vchernokulsky/cashless-dev/_docs/PinMapping.pdf

Пин | Назначение
P13 | MDB-RES | Сброс модуля MDB
P12 | I2C3-SCL | Шина I2C для дисплея или внешних устройств
P11 | I2C3-SDA | Шина I2C для дисплея или внешних устройств
P10 | NFC-INT | Вход прерывания от NFC
P9 | DEBUG-RX | Отладочный UART
P8 | DEBUG-TX | Отладочный UART
P7 | GPIO-1 | Вывод общего назначения
P6 | GPIO-2 | Вывод общего назначения
P5 | GPIO-3 | Вывод общего назначения
P4 | GPIO-4 | Вывод общего назначения
P3 | GPIO-5 | Вывод общего назначения
P2 | LD-LINK | Светодиод состояния соединения «1» - светит (ON) «0» - не светит (OFF)
P1 | ETH-INT | Вход прерывания от Ethernet
P0 | ETH-RST | Сброс модуля Ethernet
А0 | MDB-RX
А1 | MDB-TX
А2 | WIFI-RX
А3 | WIFI-TX
А4 | WIFI-RES | Сброс модуля WIFI
А5 | LD-SERVICE | Светодиод состояния соединения «1» - светит (ON) «0» - не светит (OFF)
