vchernokulsky/cashless-dev/hardware/KiCad/Cables/Кабель MDB.odt

Перв. примен.
Справ. №

Подп. и дата
Инв. № дубл.
Взам. инв. №
Подп. и дата
Инв. № подл.

Перв. примен.
Справ. №

Подп. и дата
Инв. № дубл.
Взам. инв. №
Подп. и дата
Инв. № подл.

Зона | Поз. обозн. | Наименование | Кол. | Примечание
| | Разъемы, кнопки
| XP1 | Розетка на кабель 39-01-2060 ( 6 контактов, шаг 4.2 мм) | 1 | Примечание 1,2
| | Контакт | 3 | Примечание 1,3
| XP2 | Розетка на кабель CHU-3 | 1
| | Провода
| 1-3 | Кабель коммуникационный CCC-2G, L = 500 мм | 1
| | Примечания
| | Примечание 1
| | Производитель MOLEX
| | Примечание 2
| | Допускается замена на аналогичные изделия других производителей:
| | 172168-1 — производства TE Connectivity
| | DS1073-02-2x3-FСT6 — производства Ningbo Zhenqin Electronic (Connfly Electronic)
| | Примечание 3
| | Допускается замена на аналогичные изделия других производителей:
| | 171639-1 — производства TE Connectivity

Изм. Лист № документа Подпись Дата АБВГ.123456.000 ПЭ Лист 0

Изм. Лист № документа Подпись Дата АБВГ.123456.000 ПЭ Разраб. Касперович С.Ю. 22.04.16 Проверил Н.контр. Утвердил Кабель MDB перечень элементов Лит. Лист Листов 2 2 АО «»
