vchernokulsky/cashless-dev/hardware/KiCad/Cables/Кабель питания.odt

Перв. примен.
Справ. №

Подп. и дата
Инв. № дубл.
Взам. инв. №
Подп. и дата
Инв. № подл.

Перв. примен.
Справ. №

Подп. и дата
Инв. № дубл.
Взам. инв. №
Подп. и дата
Инв. № подл.

Зона | Поз. обозн. | Наименование | Кол. | Примечание
| | Разъемы
| XP1 | MOLEX 0019091151 | 1
| XP2 | MOLEX 0019092151 | 1
| XP3 | CHU-2 | 1
| | Прочее
| 1-4 | Провод НВ-4-0.2, L = 400 мм | 4

Изм. Лист № документа Подпись Дата АБВГ.123456.000 ПЭ Лист 0

Изм. Лист № документа Подпись Дата АБВГ.123456.000 ПЭ Разраб. Касперович С.Ю. 22.04.16 Проверил Н.контр. Утвердил Кабель питания перечень элементов Лит. Лист Листов 2 2 АО «»
