vchernokulsky/cashless-dev/hardware/KiCad/W5500Shield/W5500-SHiled.odt

Перв. примен.
Справ. №

Подп. и дата
Инв. № дубл.
Взам. инв. №
Подп. и дата
Инв. № подл.

Перв. примен.
Справ. №

Подп. и дата
Инв. № дубл.
Взам. инв. №
Подп. и дата
Инв. № подл.

Зона | Поз. обозн. | Наименование | Кол. | Примечание
| | Микросхемы
| DD1 | W5500 (LQFP-48) | 1 | Wiz Net
| | Диоды, транзисторы
| LD1 | SMD 0603 - KP-1608SGC | 1 | Kingbright
| | Резисторы
| R1 | SMD 0603 — 1M 1% (CRCW06031M00FKEA или RC0603FR-071ML) | 1 | VISHAY,Yageo
| R14 - R17 | SMD 0603 — 33 Ом 1% (RC0603FR-0733RL) | 4 | Yageo
| R20 - R23 | SMD 0603 — 49R9 1% (RC0603FR-0749R9L) | 4 | Yageo
| R18, R19, R25 | SMD 0603 — 330 Ом 5% (RC0603FR-07330RL) | 3 | Yageo
| R24 | SMD 0603 — 10R 1% (RC0603FR-0710RL) | 1 | VISHAY
| R3 | SMD 0603 — 0 Ом (RC0603JR-070RL) | 1 | Yageo
| R2, R4 — R12,R26, R27 | SMD 0603 — 10k 5% (RC0603FR-0710KL) | 12 | Yageo
| R13 | SMD 0603 — 12.4k 1% (RC0603FR-0712K4L) | 1 | Yageo
| | Конденсаторы
| C1, C3 | SMD 0603 - 18pF NP0 (GRM1885C1H180JA01D) | 2 | Murata
| C10 | SMD 0603 - 4.7uFx6V3 X7R (CC0603KRX5R5BB475) | 1 | Yageo
| C8, C11 | SMD 0603 – 10nF x 50V X7R (CC0603KRX7R9BB103) | 2 | Yageo
| C6, C7 | SMD 0603 – 6.8nF x 50V X7R (CC0603KRX7R9BB682) | 2 | Yageo
| C4, C9 | 10uFx16V Танталовый, тип А (293D106X9016A2TE3) | 2 | VISHAY
| C2, C5, C12, C15 - C21 | SMD 0603 - 100nFx10V X7R (CC0603KRX7R9BB104) | 10 | Yageo
| C14 | SMD 0603 - 22nFx50V X7R (CC0603KRX7R9BB223) | 1 | Yageo
| C13 | SMD 1206 – 1nFx2kV X7R (CC1206KKX7RDBB102) | 1 | Yageo
| | Индуктивности
| L1 | SMD 0603 — 1000 @ 100Mhz (BLM18AG102SN1D) | 1 | Murata
| | Кварцевые резонаторы
| X1 | ABM3C-25.000MHZ-D4Y-T | 1 | ABRACON
| | Разъемы
| XP1 | PLD-10 | 1
| P1 | HR911105A | 1
| | Прочее

Изм. Лист № документа Подпись Дата АБВГ.123456.000 ПЭ Лист 2

Изм. Лист № документа Подпись Дата АБВГ.123456.000 ПЭ Разраб. 22.04.16 Проверил Н.контр. Утвердил W5500-SHiled перечень элементов Лит. Лист Листов 1 2 АО «»
