vchernokulsky/cashless-dev/hardware/KiCad/W5500Shield/W5500 Shield-Низ.jpg

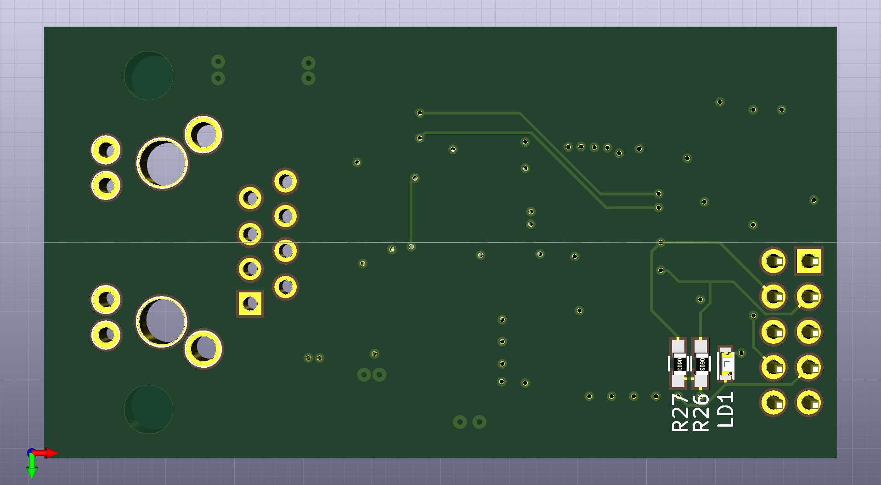
hardware/KiCad/W5500Shield/W5500 Shield-Низ.jpg
