vchernokulsky/cashless-dev/hardware/KiCad/KiCad.FCStd

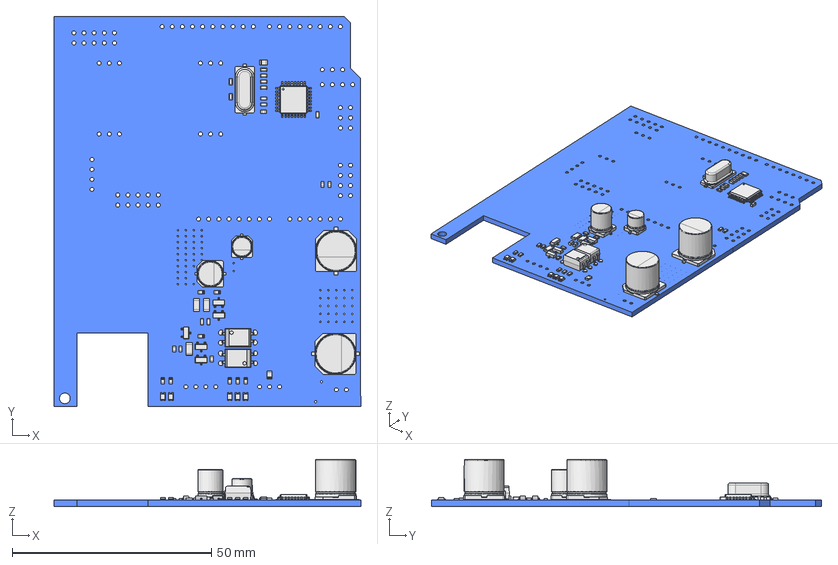
[picture p3: CAD file, 2016-11-25]
hardware/KiCad/KiCad.FCStd
76.9 x 97.8 x 11.8 mm
Pcb
c_0603_h078_
r_0603_h078_
r_0603_h078_001
r_0603_h078_002
r_0603_h078_003
r_0603_h078_004
r_0603_h078_005
r_0603_h078_006
r_0603_h078_007
DBCC3AE1-0DB8-4925-91AA-5759F3836E66_
User_Library-Crystal_HC49_US-SM_
r_0603_h078_008
c_0603_h078_001
r_0603_h078_009
r_0603_h078_010
r_1206_h055_
r_0603_h078_011
r_0603_h078_012
DBCC3AE1-0DB8-4925-91AA-5759F3836E66_001
DBCC3AE1-0DB8-4925-91AA-5759F3836E66_002
DBCC3AE1-0DB8-4925-91AA-5759F3836E66_003
DBCC3AE1-0DB8-4925-91AA-5759F3836E66_004
ASSEMBLY_
ASSEMBLY_001
ASSEMBLY_002
r_0805_h078_
ASSEMBLY_003
r_1206_h055_001
r_1206_h055_002
c_0603_h078_002
c_0603_h078_003
c_0603_h078_004
c_0603_h078_005
c_0603_h078_006
c_0603_h078_007
c_0603_h078_008
c_0603_h078_009
c_0603_h078_010
lqfp32_7x7_p08_
r_0805_h078_001
r_0603_h078_013
