vchernokulsky/cashless-dev/hardware/KiCad/W5500Shield/W5500 Shield-Edge.Cuts.dxf

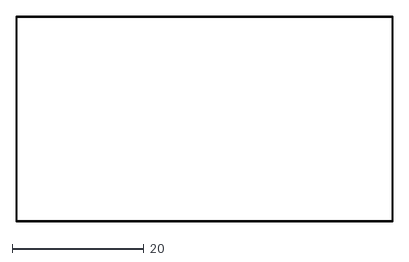
[picture p4: CAD file, 2016-11-25]
hardware/KiCad/W5500Shield/W5500 Shield-Edge.Cuts.dxf
57.1 x 31.1
