vchernokulsky/cashless-dev/hardware/KiCad/Ethernet-Shiled.dxf

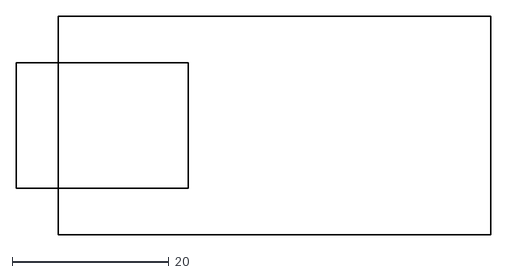
[picture p5: CAD file, 2016-11-25]
hardware/KiCad/Ethernet-Shiled.dxf
60.6 x 27.9
