vchernokulsky/cashless-dev/hardware/KiCad/W5500Shield/W5500 Shield-F.Fab.dxf

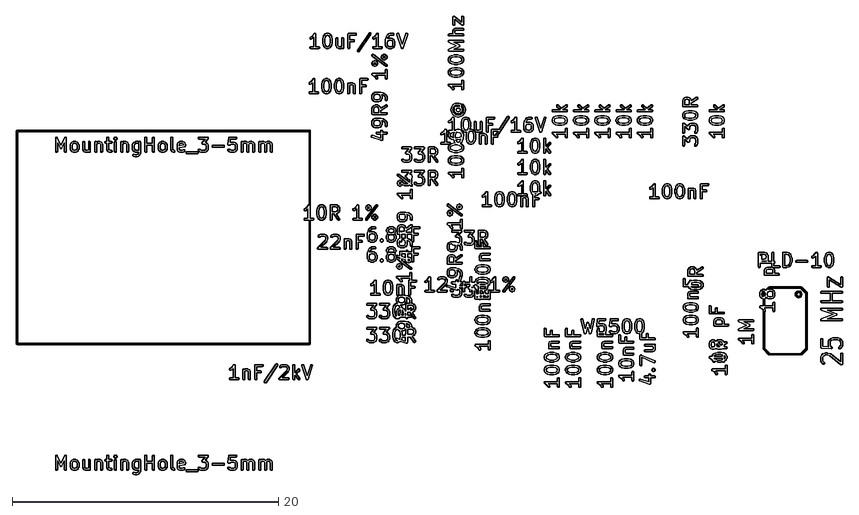
[picture p6: CAD file, 2016-11-25]
hardware/KiCad/W5500Shield/W5500 Shield-F.Fab.dxf
62.1 x 34.5
