vchernokulsky/cashless-dev/hardware/KiCad/CDRH127.dxf

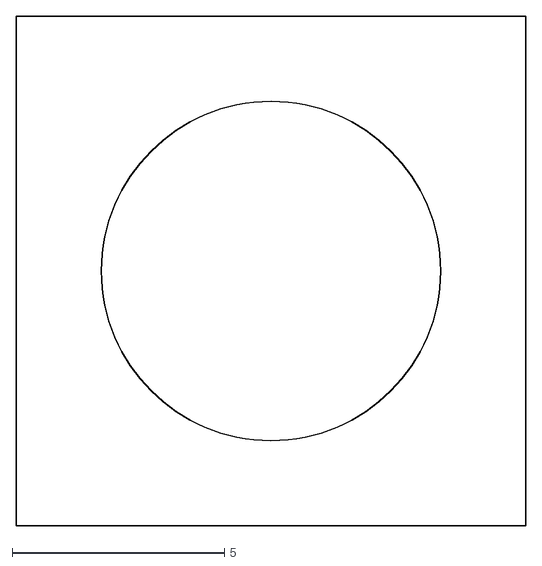
[picture p7: CAD file, 2016-11-25]
hardware/KiCad/CDRH127.dxf
12.0 x 12.0
