vchernokulsky/cashless-dev/hardware/KiCad/ABM3C.dxf

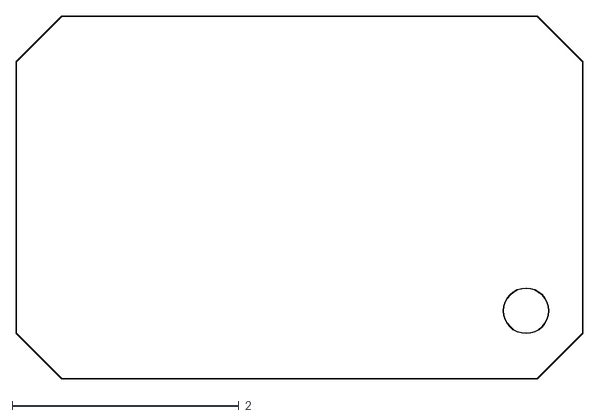
[picture p8: CAD file, 2016-11-25]
hardware/KiCad/ABM3C.dxf
5.00 x 3.20
