vchernokulsky/cashless-dev/hardware/KiCad/ESP8266-01.dxf

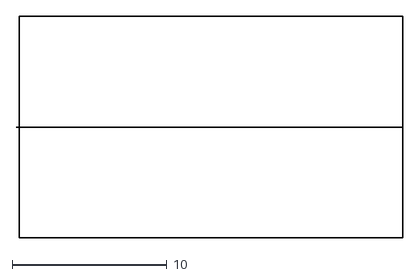
[picture p9: CAD file, 2016-11-25]
hardware/KiCad/ESP8266-01.dxf
25.0 x 14.3
