vchernokulsky/cashless-dev/hardware/KiCad/SL-ПЭ3.pdf

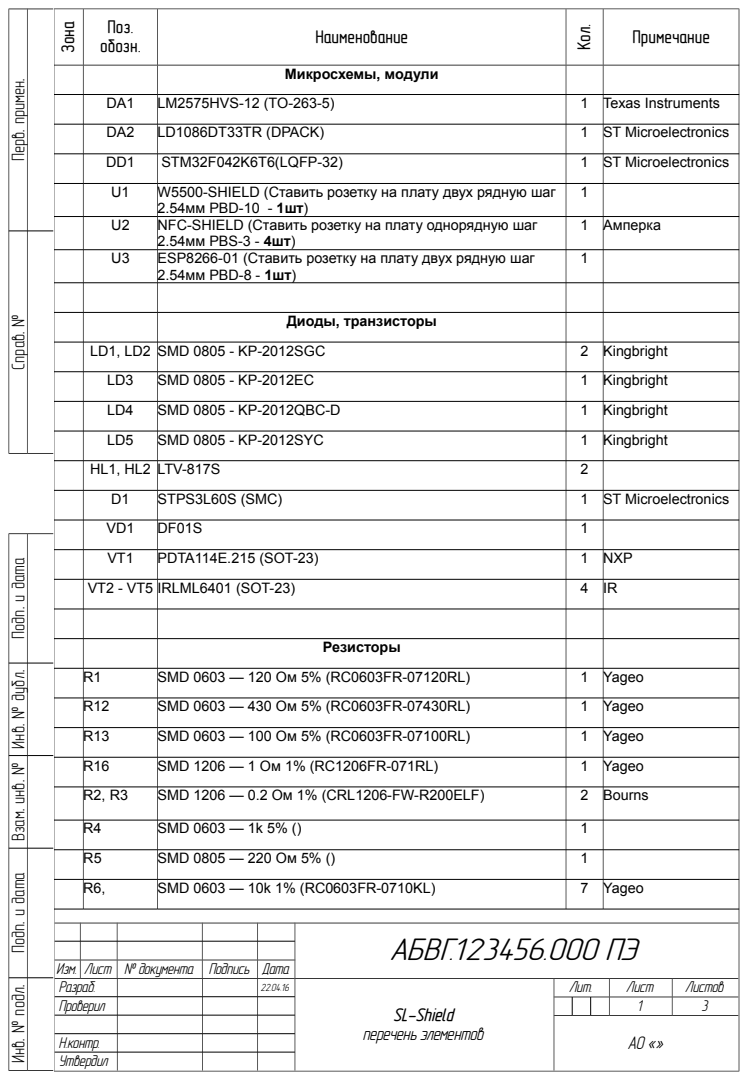
[picture p10: page 1]

Изм. Лист № документа Подпись Дата
Проверил

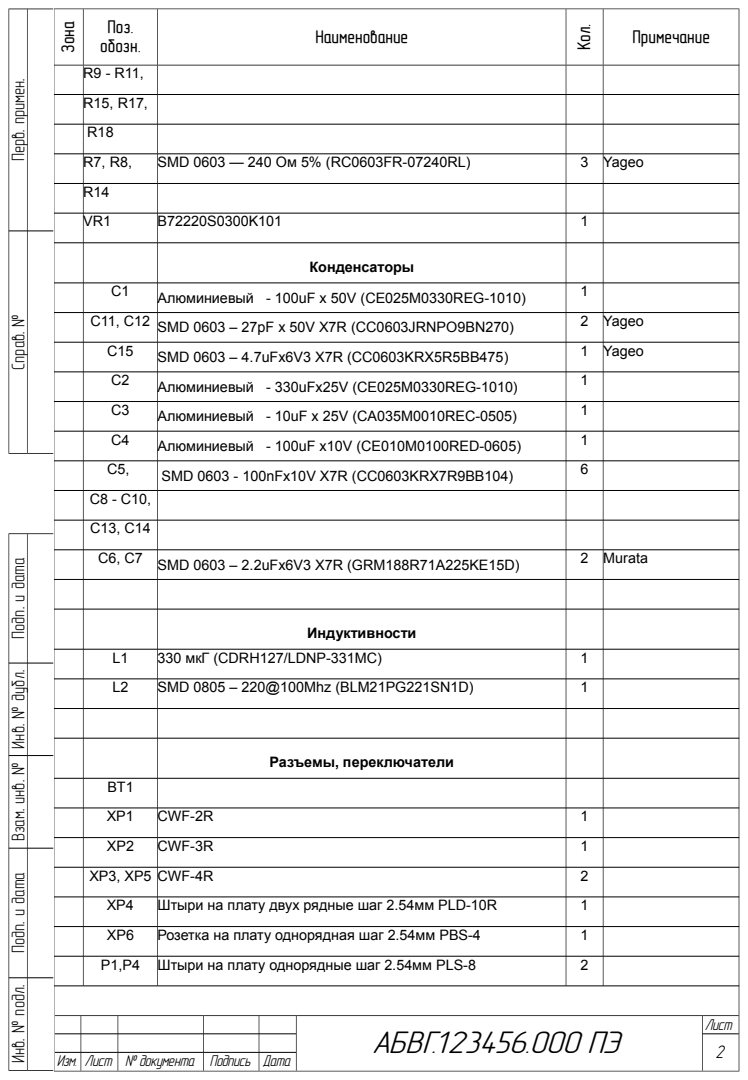
[picture p11: page 2]

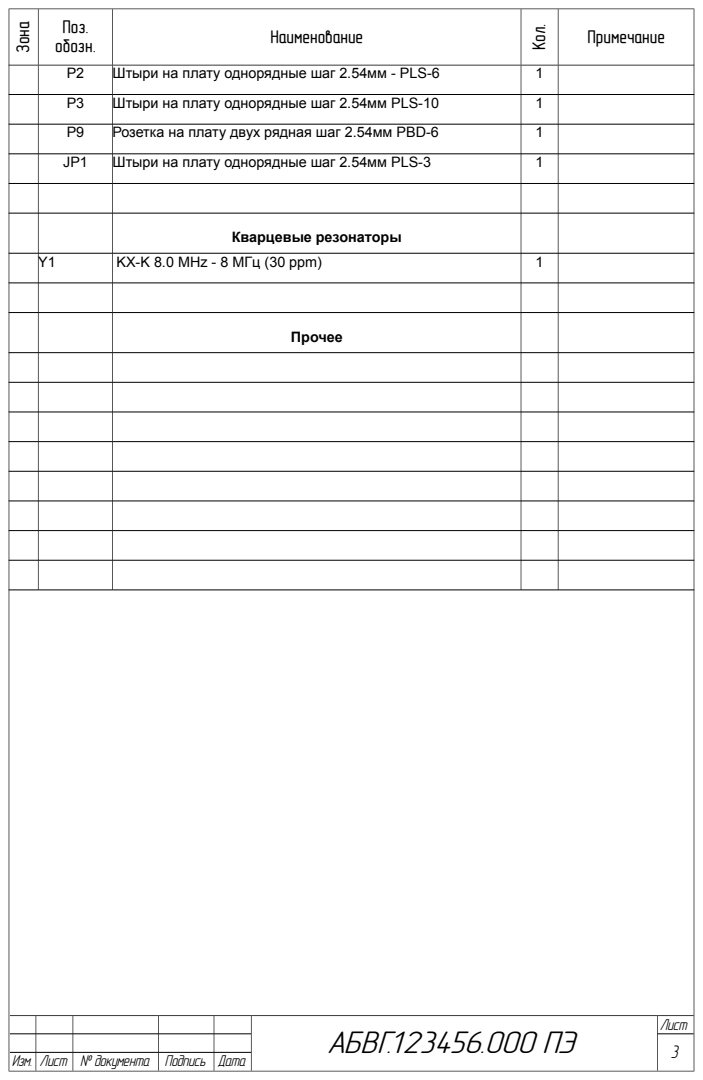
[picture p12: page 3]
Штыри на плату однорядные шаг 2.54мм - PLS-6; Штыри на плату однорядные шаг 2.54мм PLS-10; Розетка на плату двух рядная шаг 2.54мм PBD-6; Штыри на плату однорядные шаг 2.54мм PLS-3; Кварцевые резонаторы; KX-K 8.0 MHz - 8 МГц (30 ppm); Прочее; Изм.; Лист; № документа; Подпись; Дата; АБВГ.123456.000 ПЭ; Лист 3
