vchernokulsky/cashless-dev/hardware/KiCad/SL-СБ-ВЕРХ.pdf

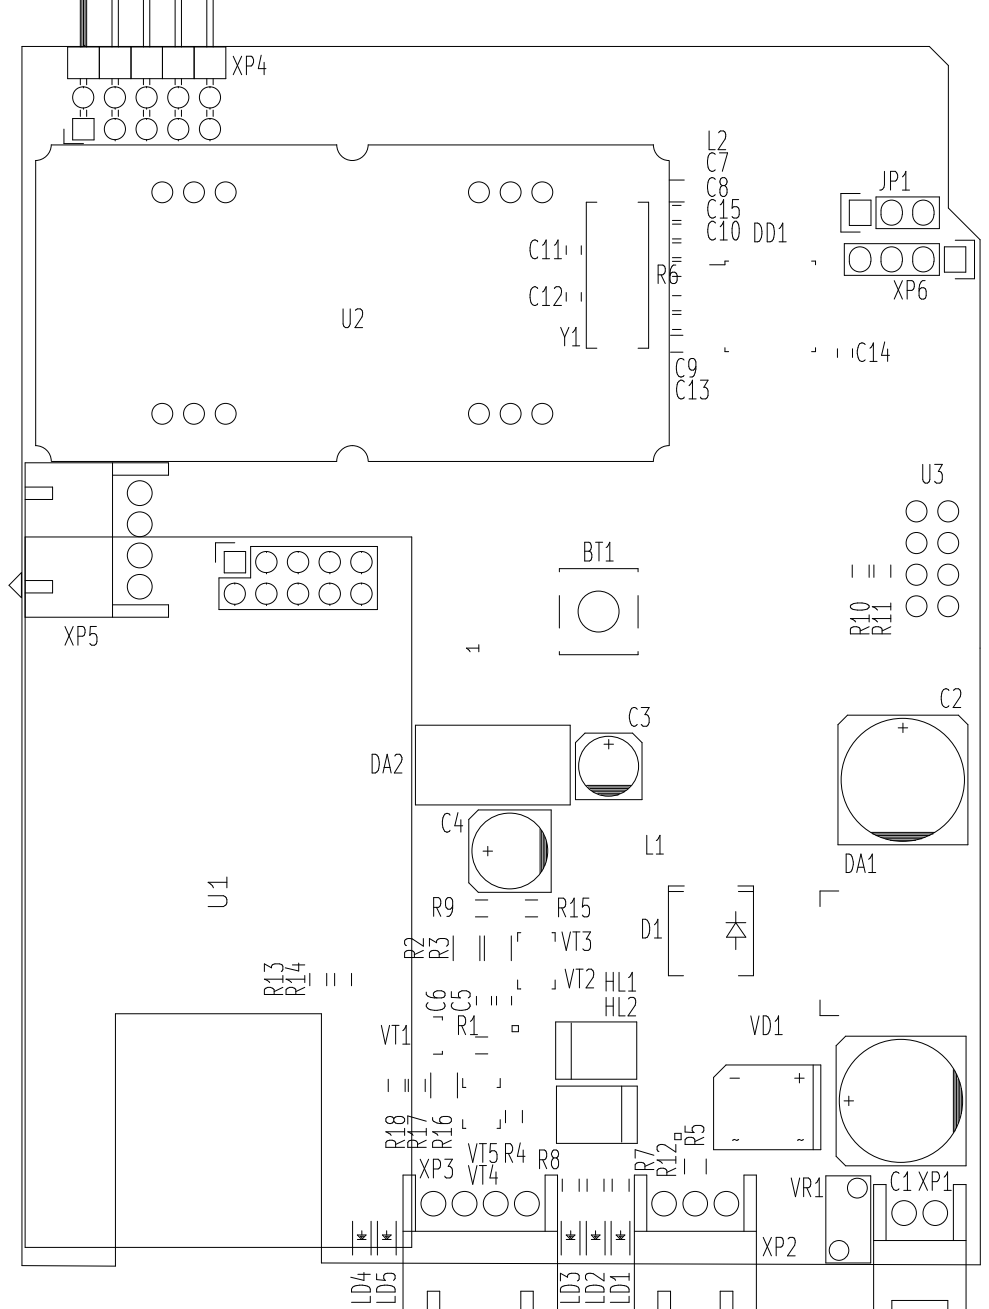
[picture p13: page 1]
