vchernokulsky/cashless-dev/hardware/KiCad/SL-СБ-НИЗ.pdf

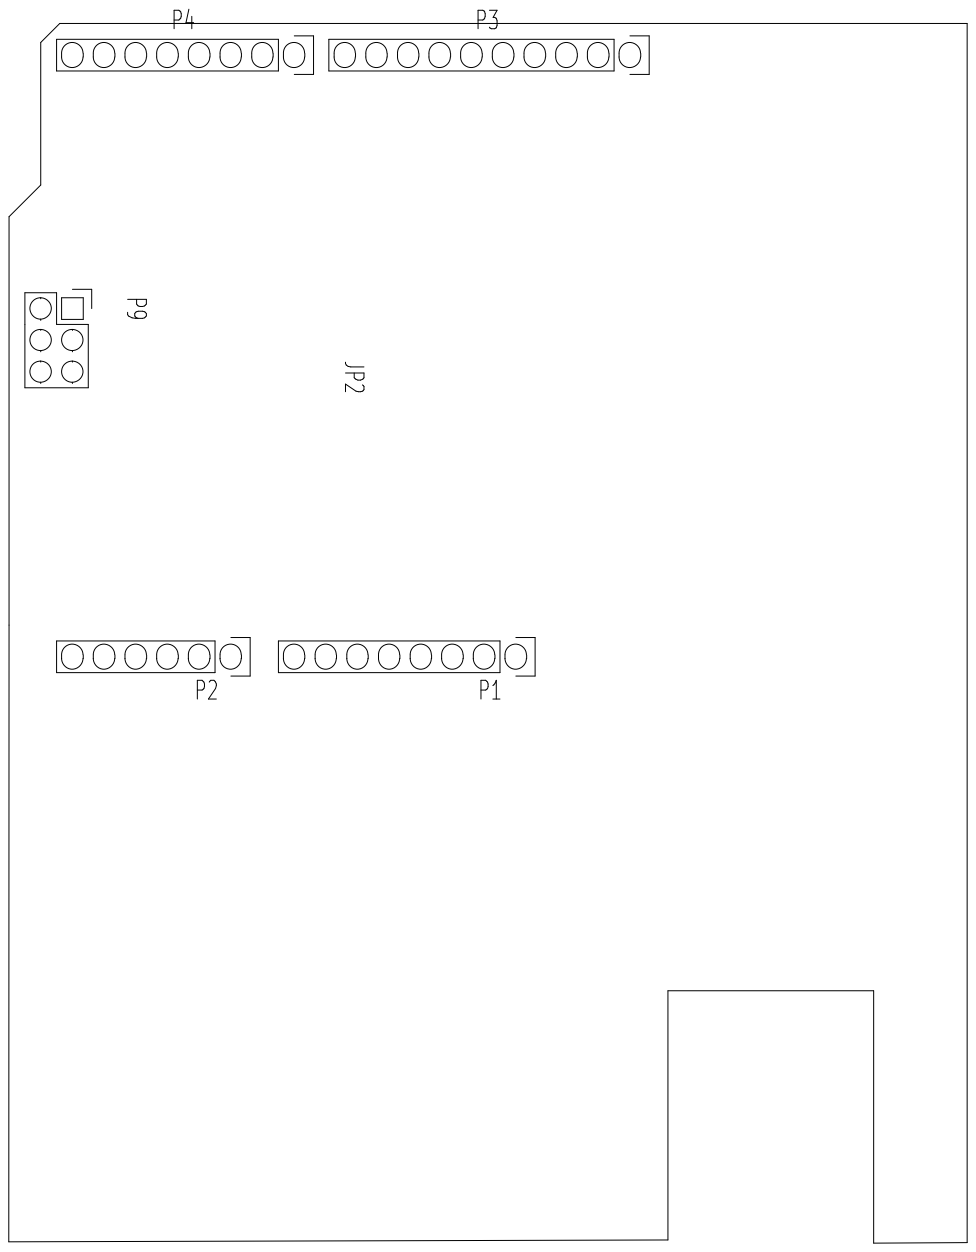
[picture p14: page 1]
