vchernokulsky/cashless-dev/hardware/KiCad/Cables/Кабель MDB - ПЭ3.pdf

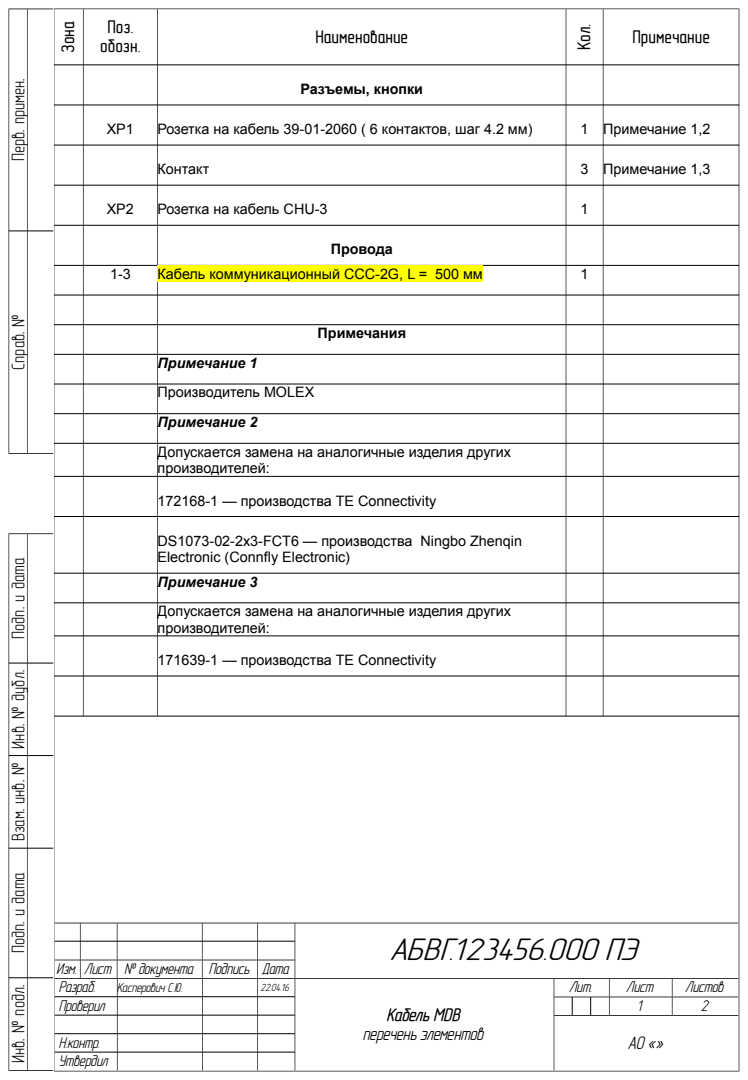
[picture p15: page 1]
Зона; Поз.; обозн.; Наименование; Кол.; Примечание; Разъемы, кнопки; Розетка на кабель 39-01-2060 ( 6 контактов, шаг 4.2 мм); 1 Примечание 1,2; Контакт; 3 Примечание 1,3; Розетка на кабель CHU-3; Провода; Кабель коммуникационный CCC-2G, L = 500 мм; Примечания; АБВГ.123456.000 ПЭ; Разраб.; Касперович С.Ю.; Н.контр. Утвердил; Кабель MDB перечень элементов; Лит.; Лист; Листов; Подп. и да; м. инв. №; Инв. № подл.

Перв. примен. Справ. №

Примечание 1
Производитель MOLEX
Примечание 2
Допускается замена на аналогичные изделия других
производителей:

172168-1 — производства TE Connectivity

DS1073-02-2x3-FСT6 — производства Ningbo Zhenqin
Electronic (Connfly Electronic)
Примечание 3

171639-1 — производства TE Connectivity

Инв. № дубл. Вза

Изм. Лист № документа Подпись Дата
Проверил

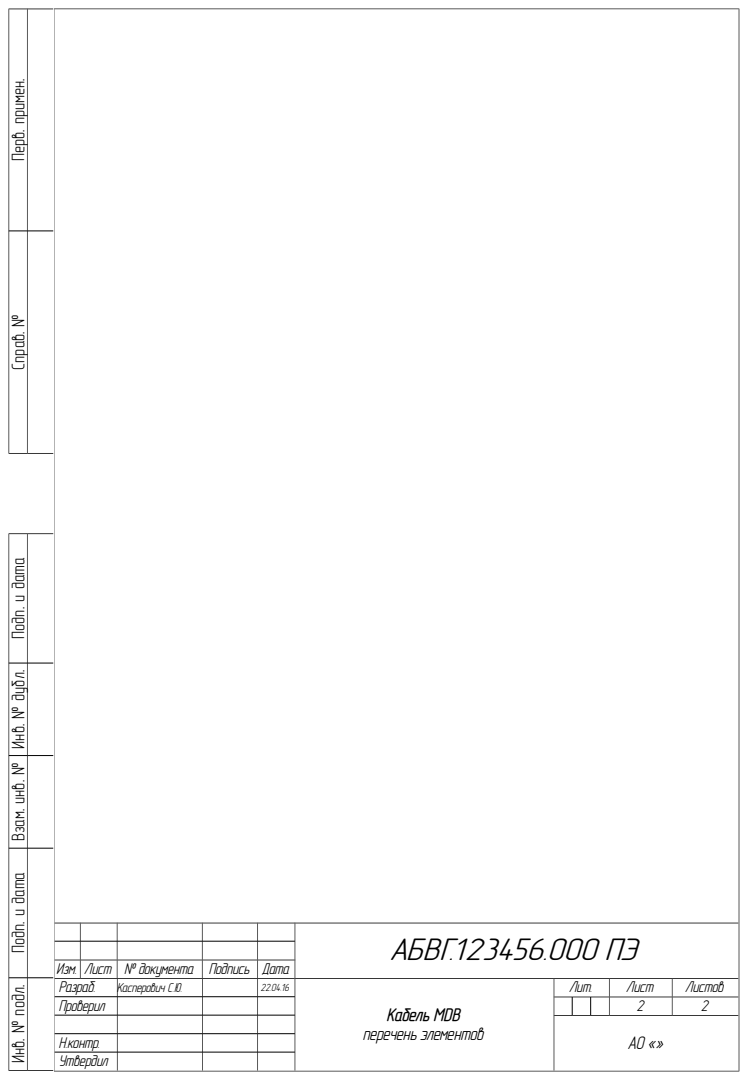
[picture p16: page 2]
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

Перв. примен. Справ. №

Инв. № дубл. Вза

Изм. Лист № документа Подпись Дата
Проверил
