vchernokulsky/cashless-dev/hardware/KiCad/Cables/Кабель MDB-Э3.pdf

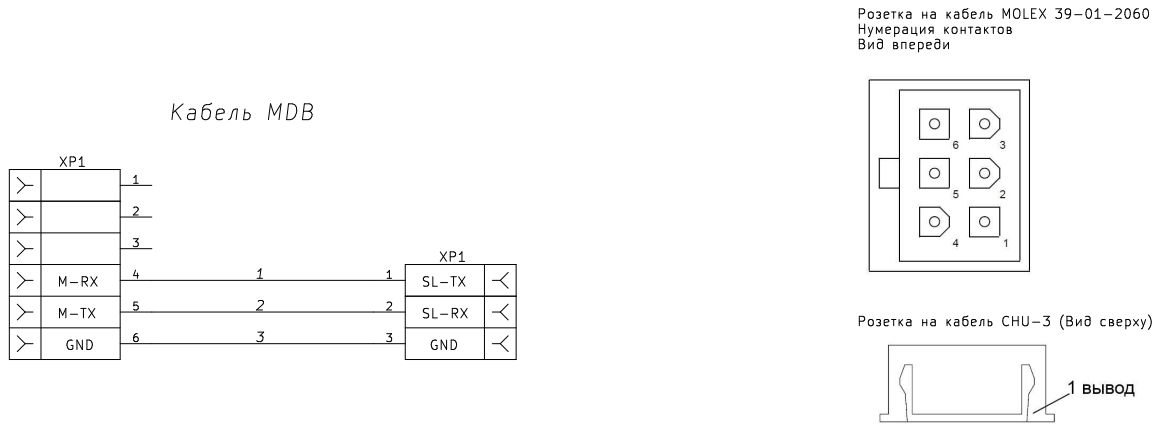
[picture p17: page 1]
