vchernokulsky/cashless-dev/hardware/KiCad/Cables/Кабель питания -Э3.pdf

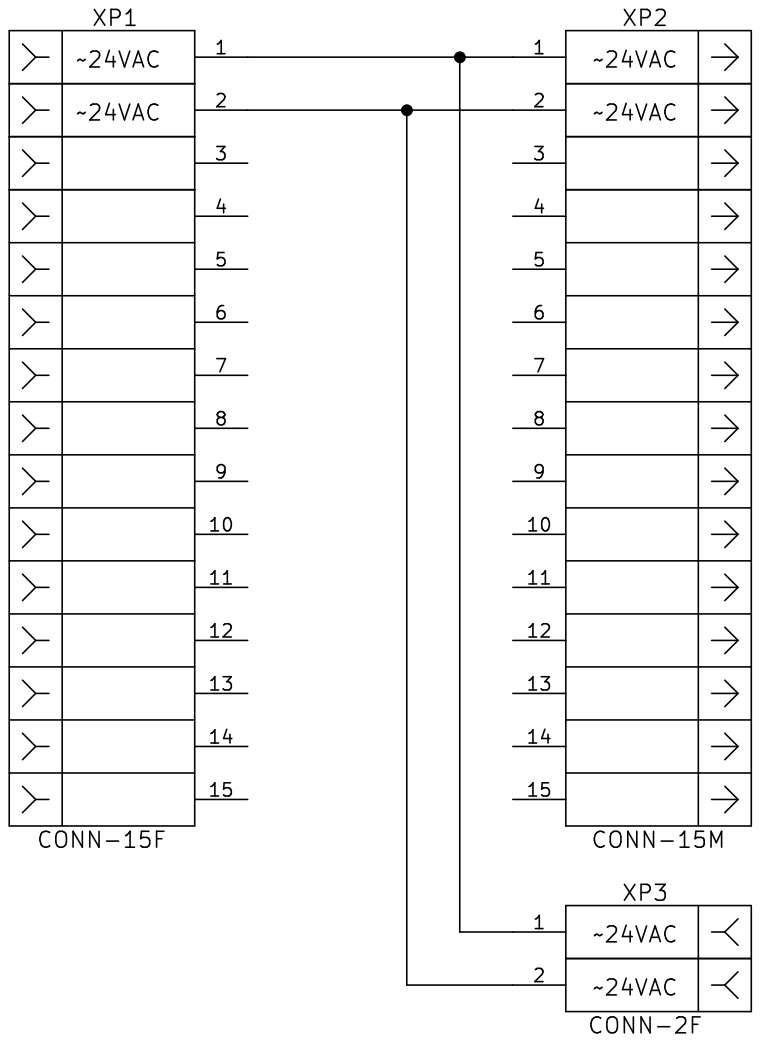
[picture p18: page 1]
