vchernokulsky/cashless-dev/hardware/KiCad/Cables/Кабель питания.pdf

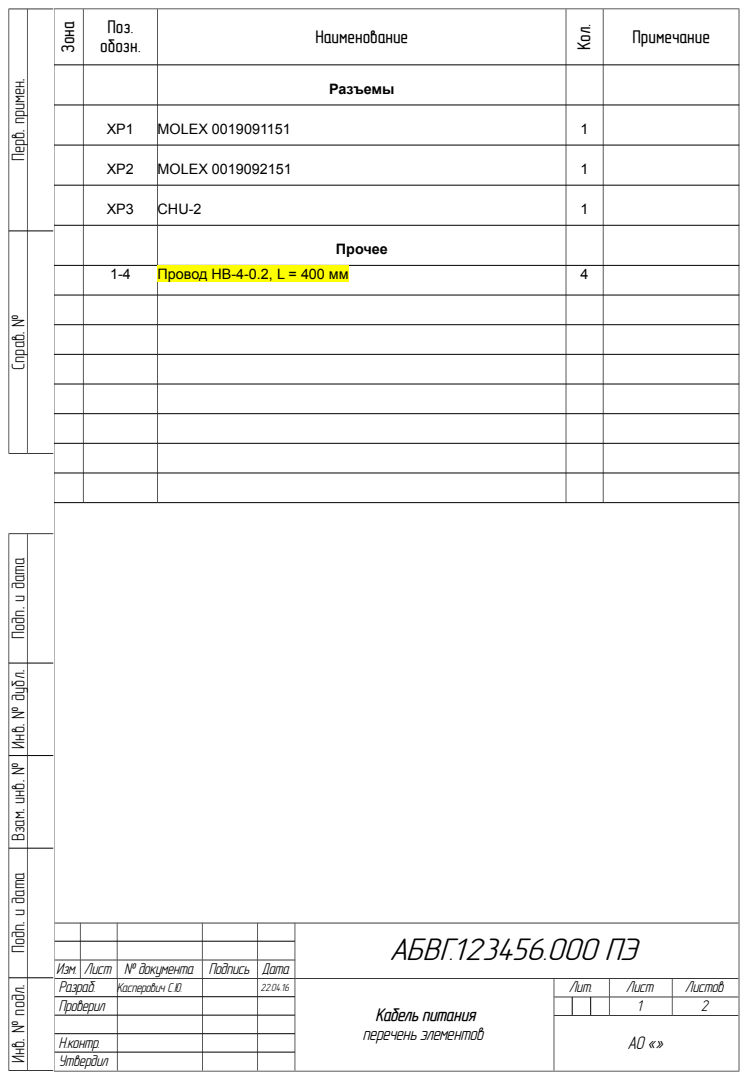
[picture p19: page 1]
Зона; Поз.; обозн.; Наименование; Кол.; Примечание; Разъемы; MOLEX 0019091151; MOLEX 0019092151; CHU-2; Прочее; Провод НВ-4-0.2, L = 400 мм; АБВГ.123456.000 ПЭ; Разраб.; Касперович С.Ю.; Н.контр. Утвердил; Кабель питания перечень элементов; Лит.; Лист; Листов; Подп. и да; м. инв. №; Инв. № подл.

Перв. примен. Справ. №

Инв. № дубл. Вза

Изм. Лист № документа Подпись Дата
Проверил

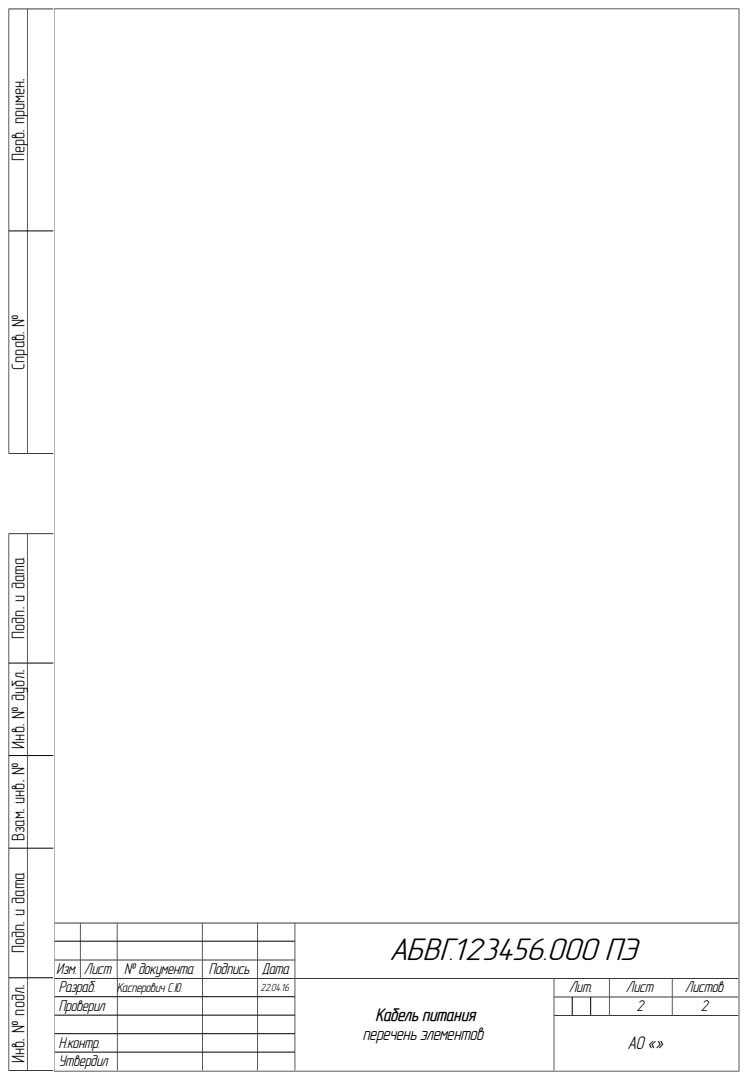
[picture p20: page 2]
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

Перв. примен. Справ. №

Инв. № дубл. Вза

Изм. Лист № документа Подпись Дата
Проверил
