vchernokulsky/cashless-dev/hardware/KiCad/W5500Shield/W5500 Shield.pdf

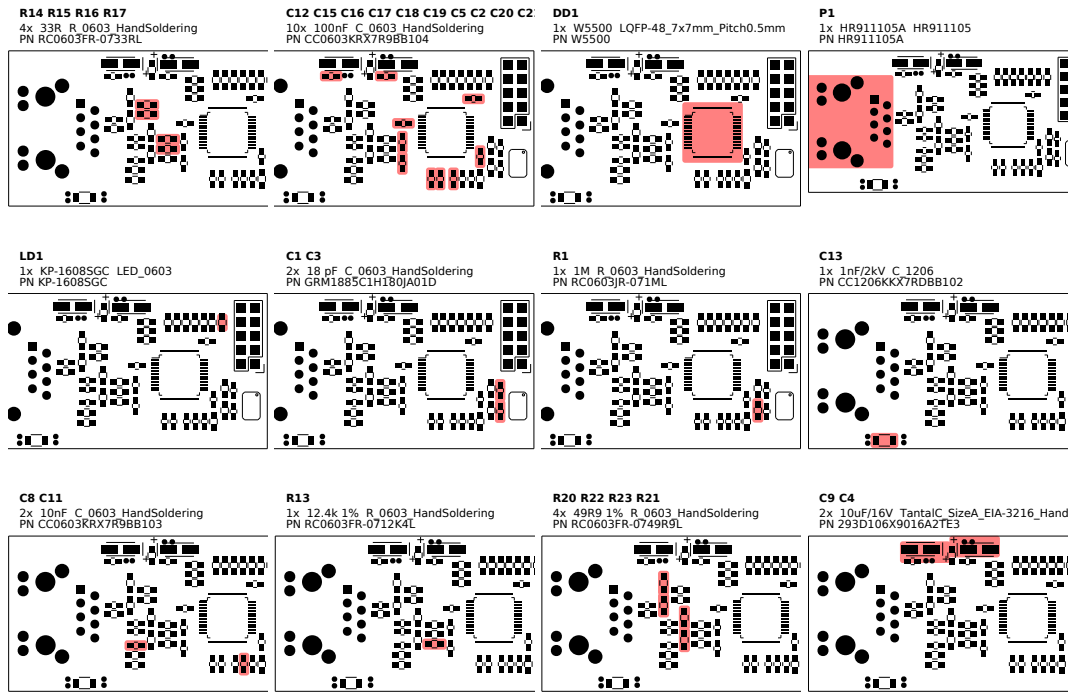
[picture p21: page 1]

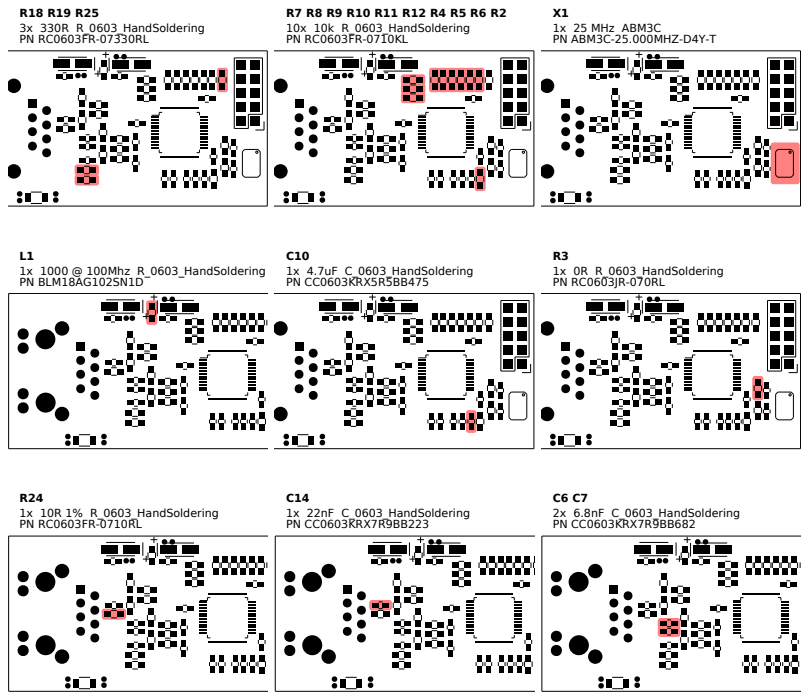
[picture p22: page 2]
