vchernokulsky/cashless-dev/hardware/KiCad/W5500Shield/W5500-SHiledПЭ3.pdf

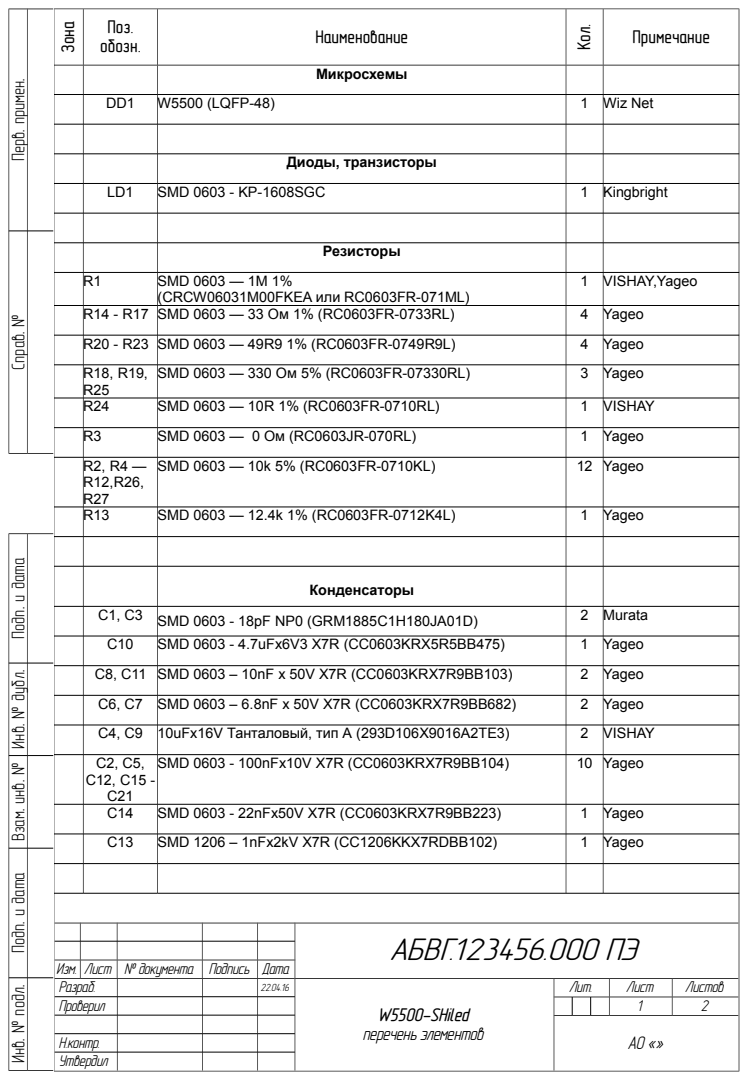
[picture p23: page 1]

Изм. Лист № документа Подпись Дата
Проверил

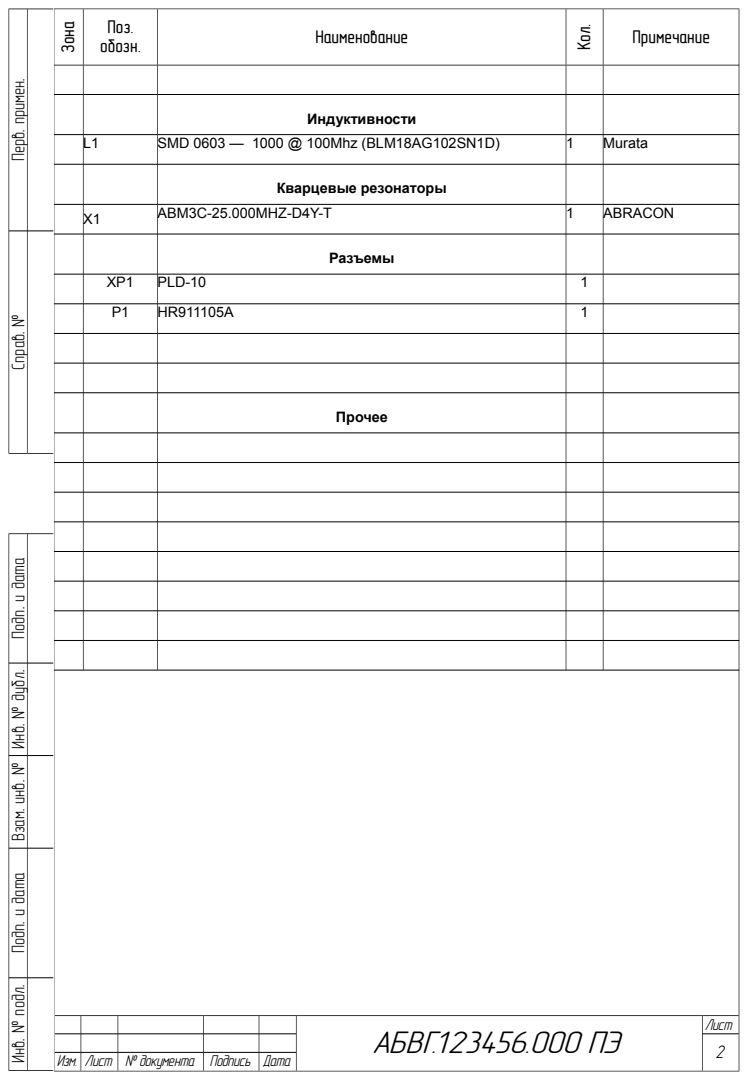
[picture p24: page 2]
Зона; Поз.; обозн.; Наименование; Кол.; Примечание; Индуктивности; SMD 0603 — 1000 @ 100Mhz (BLM18AG102SN1D); Murata; Кварцевые резонаторы; ABM3C-25.000MHZ-D4Y-T; ABRACON; Разъемы; PLD-10; Прочее; Изм.; Лист; № документа; Подпись; Дата; АБВГ.123456.000 ПЭ; Лист 2; Подп. и да; м. инв. №; Инв. № подл.

Перв. примен. Справ. №

Инв. № дубл. Вза
