vchernokulsky/cashless-dev/hardware/KiCad/KiCad.kicad_pcb

## KiCad design hardware/KiCad/KiCad.kicad_pcb (2016-11-25)

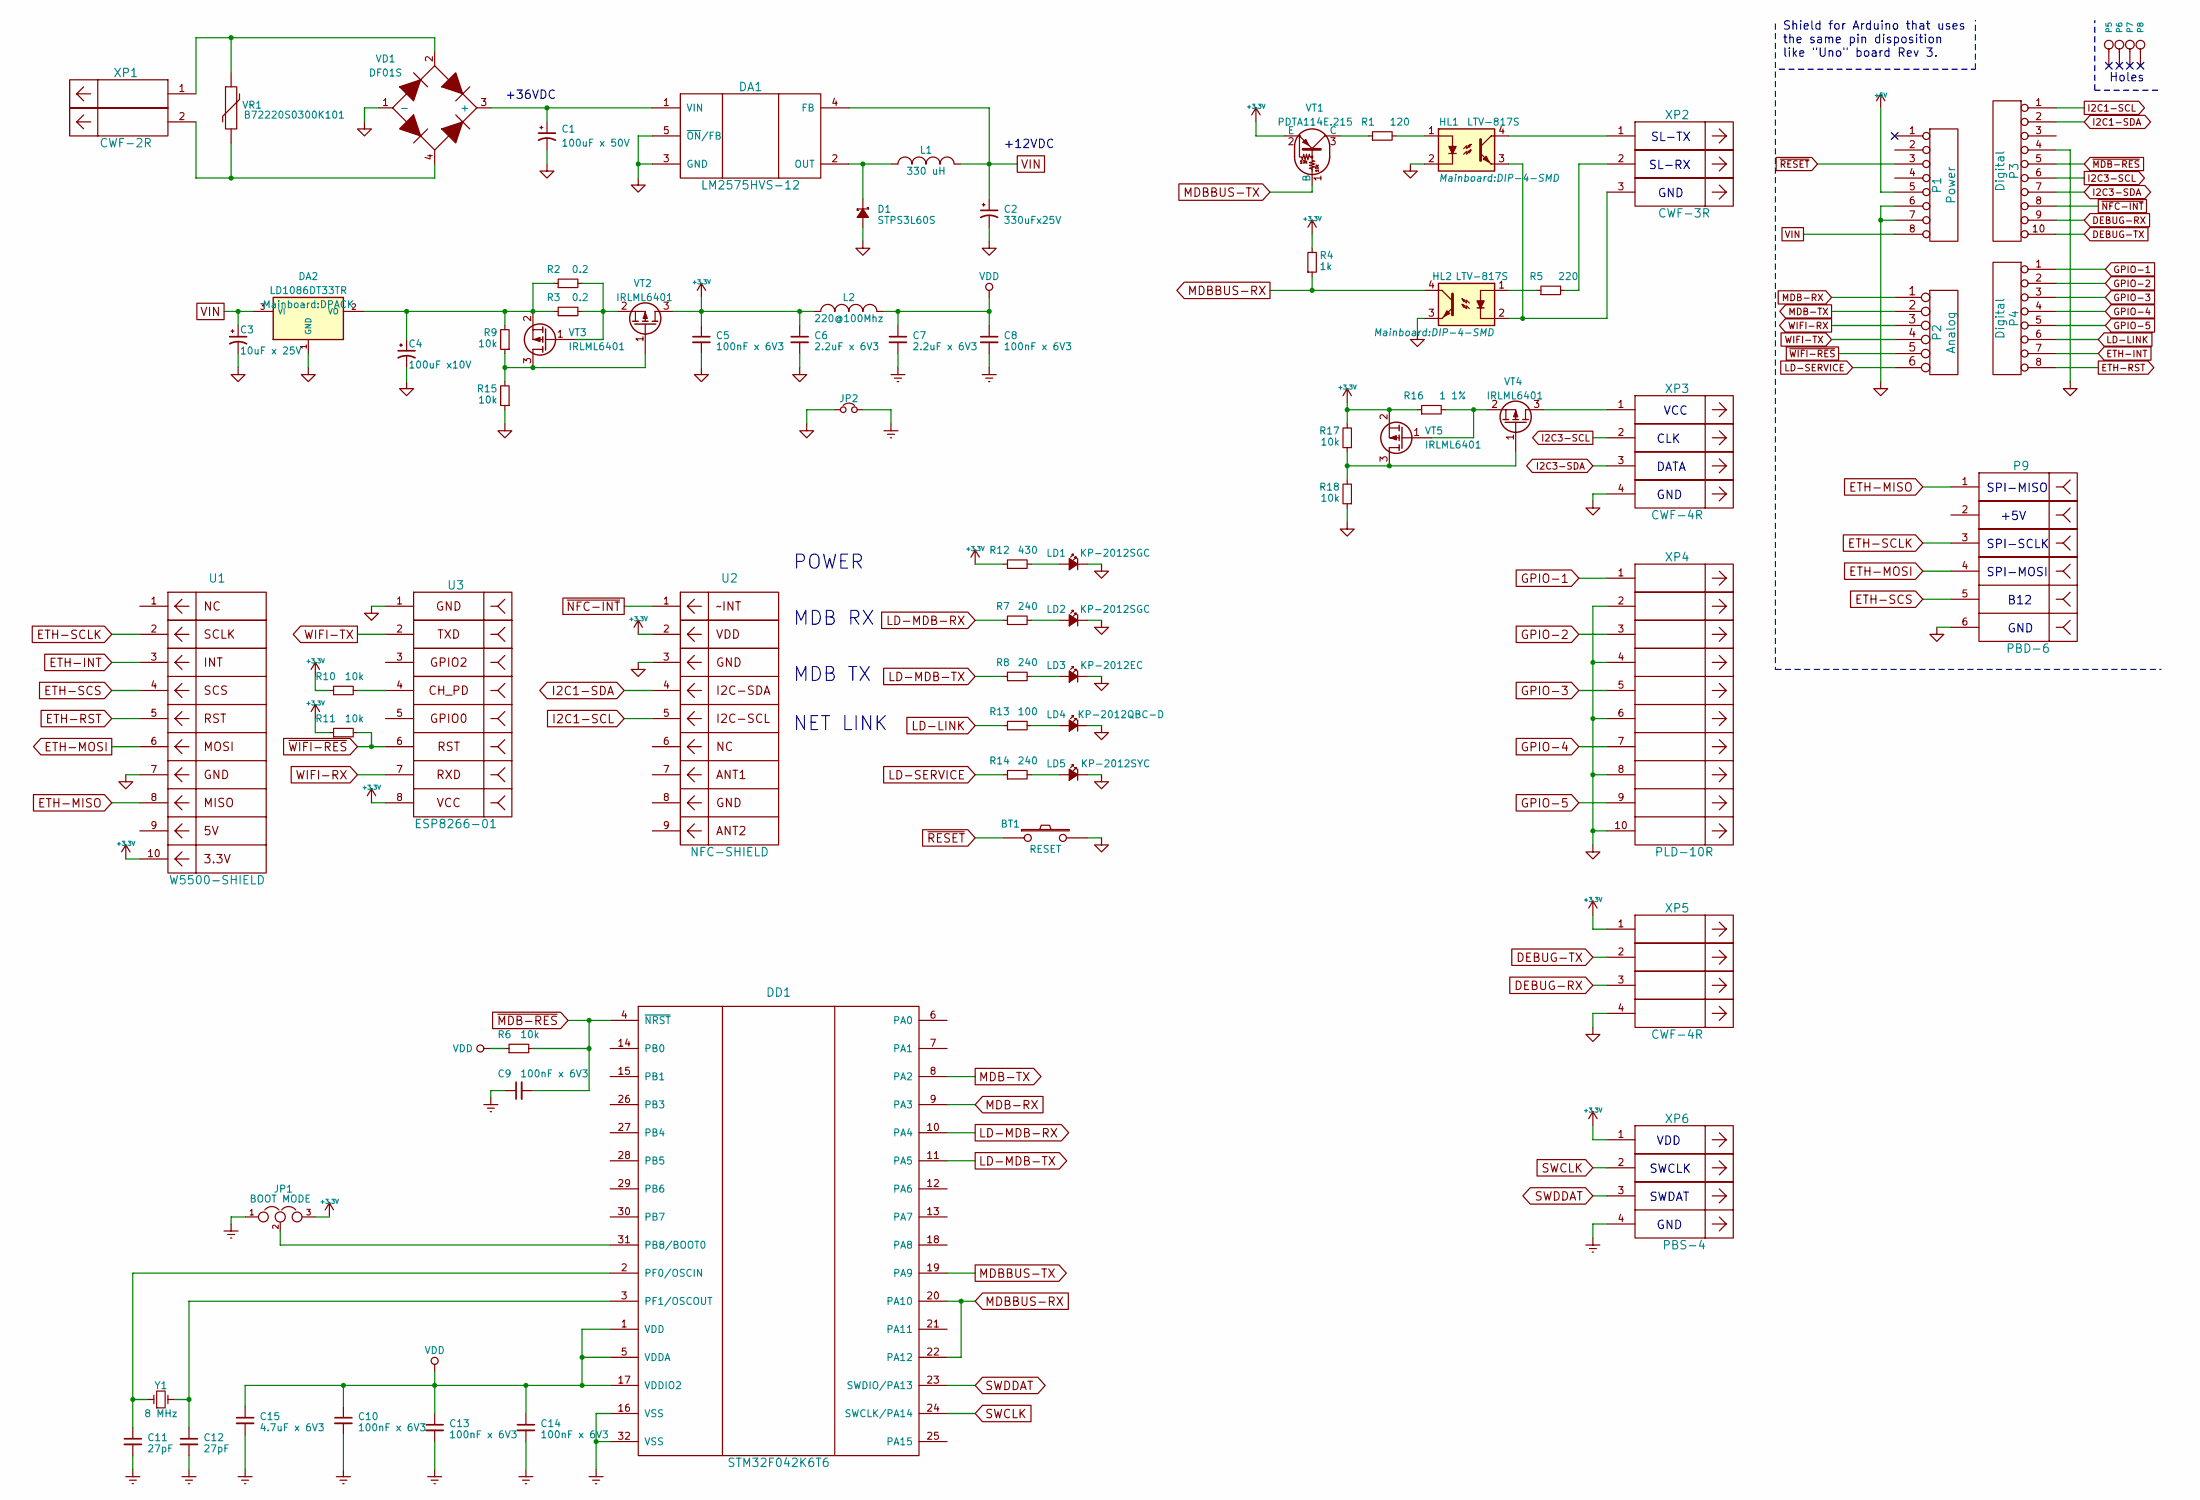
[picture p25: schematic KiCad.sch]

Parts:
BT1: RESET; SW_SPST_B3S-1000
C1: 100uF x 50V; c_elec_10x10
C2: 330uFx25V; c_elec_10x10
C3: 10uF x 25V; c_elec_5x5.3
C4: 100uF x10V; c_elec_6.3x7.7
C5, C8, C9, C10, C13, C14: 100nF x 6V3; C_0603_HandSoldering
C6, C7: 2.2uF x 6V3; C_0603_HandSoldering
C11, C12: 27pF; C_0603_HandSoldering
C15: 4.7uF x 6V3; C_0603_HandSoldering
D1: STPS3L60S; SMC_Standard
DA1: LM2575HVS-12; TO-263-5Lead
DA2: LD1086DT33TR; DPACK
DD1: STM32F042K6T6; LQFP-32_7x7mm_Pitch0.8mm
HL1, HL2: LTV-817S; DIP-4-SMD
JP1: BOOT MODE; Pin_Header_Straight_1x03
JP2: Jumper_NC_Small; NetTie-I_Connected_SMD
L1: 330 uH; CDRH127
L2: 220@100Mhz; R_0805
LD1, LD2: KP-2012SGC; LED-0805
LD3: KP-2012EC; LED-0805
LD4: KP-2012QBC-D; LED-0805
LD5: KP-2012SYC; LED-0805
P1: Power; Socket_Strip_Arduino_1x08
P2: Analog; Socket_Strip_Arduino_1x06
P3: Digital; Socket_Strip_Arduino_1x10
P4: Digital; Socket_Strip_Arduino_1x08
P5, P6, P7, P8: CONN_1; Arduino_1pin
P9: PBD-6; Socket_Strip_Straight_2x03
R1: 120; R_0603_HandSoldering
R2, R3: 0.2; R_1206
R4: 1k; R_0603_HandSoldering
R5: 220; R_0805
R6, R9, R10, R11, R15, R17, R18: 10k; R_0603_HandSoldering
R7, R8, R14: 240; R_0603_HandSoldering
R12: 430; R_0603_HandSoldering
R13: 100; R_0603_HandSoldering
R16: 1 1%; R_1206
U1: W5500-SHIELD; Ethernet-Shield
U2: NFC-SHIELD
U3: ESP8266-01
VD1: DF01S
VR1: B72220S0300K101; RV_Disc_D7_W3.6_P5
VT1: PDTA114E.215; SOT-23
VT2, VT3, VT4, VT5: IRLML6401; SOT-23
XP1: CWF-2R
XP2: CWF-3R
XP3, XP5: CWF-4R
XP4: PLD-10R; Pin_Header_Angled_2x05
XP6: PBS-4; Socket_Strip_Straight_1x04
Y1: 8 MHz; Crystal_HC49-SD_SMD

Connections:
+3V3: C5.1, C6.1, JP1.3, L2.1, R4.2, R10.1, R11.1, R12.1, R16.1, R17.2, U1.10, U2.2, U3.8, VT1.2 (E), VT2.3 (D), VT5.2 (S), XP5.1, XP6.1
+5V: P1.5
DEBUG-RX: P3.9, XP5.3
DEBUG-TX: P3.10, XP5.2
ETH-INT: P4.7, U1.3
ETH-MISO: P9.1, U1.8
ETH-MOSI: P9.4, U1.6
ETH-RST: P4.8, U1.5
ETH-SCLK: P9.3, U1.2
ETH-SCS: P9.5, U1.4
GND: BT1.2, C1.2, C2.2, C3.2, C4.2, C5.2, C6.2, D1.2 (A), DA1.3 (GND), DA1.5 (~ON~/FB), DA2.1 (GND), HL1.2, HL2.3, JP2.1, LD1.1 (K), LD2.1 (K), LD3.1 (K), LD4.1 (K), LD5.1 (K), P1.6, P1.7, P3.4, P9.6, R15.1, R18.1, U1.7, U2.3, U3.1, VD1.1 (-), XP3.4, XP4.2, XP4.4, XP4.6, XP4.8, XP4.10, XP5.4
GNDREF: C7.2, C8.2, C9.1, C10.2, C11.2, C12.2, C13.2, C14.2, C15.2, DD1.16 (VSS), DD1.32 (VSS), JP1.1, JP2.2, XP6.4
GPIO-1: P4.1, XP4.1
GPIO-2: P4.2, XP4.3
GPIO-3: P4.3, XP4.5
GPIO-4: P4.4, XP4.7
GPIO-5: P4.5, XP4.9
I2C1-SCL: P3.1, U2.5
I2C1-SDA: P3.2, U2.4
I2C3-SCL: P3.6, XP3.2
I2C3-SDA: P3.7, XP3.3
LD-LINK: P4.6, R13.1
LD-MDB-RX: DD1.10 (PA4), R7.1
LD-MDB-TX: DD1.11 (PA5), R8.1
LD-SERVICE: P2.6, R14.1
MDB-RX: DD1.9 (PA3), P2.1
MDB-TX: DD1.8 (PA2), P2.2
MDBBUS-RX: DD1.20 (PA10), DD1.22 (PA12), HL2.4, R4.1
MDBBUS-TX: DD1.19 (PA9), VT1.1 (B)
unnamed: C1.1, DA1.1 (VIN), VD1.3 (+)
unnamed: C4.1, DA2.2 (VO), R2.1, R3.1, R9.2, VT3.2 (S)
unnamed: C11.1, DD1.2 (PF0/OSCIN), Y1.1
unnamed: C12.1, DD1.3 (PF1/OSCOUT), Y1.2
unnamed: D1.1 (K), DA1.2 (OUT), L1.1
unnamed: DD1.31 (PB8/BOOT0), JP1.2
unnamed: HL1.1, R1.2
unnamed: HL1.3, HL2.2, XP2.3
unnamed: HL1.4, XP2.1
unnamed: HL2.1, R5.1
unnamed: LD1.2 (A), R12.2
unnamed: LD2.2 (A), R7.2
unnamed: LD3.2 (A), R8.2
unnamed: LD4.2 (A), R13.2
unnamed: LD5.2 (A), R14.2
unnamed: R1.1, VT1.3 (C)
unnamed: R2.2, R3.2, VT2.2 (S), VT3.1 (G)
unnamed: R5.2, XP2.2
unnamed: R10.2, U3.4
unnamed: R9.1, R15.2, VT2.1 (G), VT3.3 (D)
unnamed: R16.2, VT4.2 (S), VT5.1 (G)
unnamed: R17.1, R18.2, VT4.1 (G), VT5.3 (D)
unnamed: VD1.2, VR1.1, XP1.1
unnamed: VD1.4, VR1.2, XP1.2
unnamed: VT4.3 (D), XP3.1
SWCLK: DD1.24 (SWCLK/PA14), XP6.2
SWDDAT: DD1.23 (SWDIO/PA13), XP6.3
VDD: C7.1, C8.1, C10.1, C13.1, C14.1, C15.1, DD1.1 (VDD), DD1.5 (VDDA), DD1.17 (VDDIO2), L2.2, R6.1
VIN: C2.1, C3.1, DA1.4 (FB), DA2.3 (VI), L1.2, P1.8
WIFI-RX: P2.3, U3.7
WIFI-TX: P2.4, U3.2
~MDB-RES: C9.2, DD1.4 (~NRST), P3.5, R6.2
~NFC-INT: P3.8, U2.1
~RESET: BT1.1, P1.3
~WIFI-RES: P2.5, R11.2, U3.6

Notes on the sheet:
Holes
Shield for Arduino that uses the same pin disposition like "Uno" board Rev 3.
+36VDC
SL-TX
SL-RX
GND
SWDAT
VDD
SWCLK
SPI-MISO
+5V
SPI-SCLK
SPI-MOSI
B12
+12VDC
MDB RX
MDB TX
NET LINK
VCC
CLK
DATA
POWER

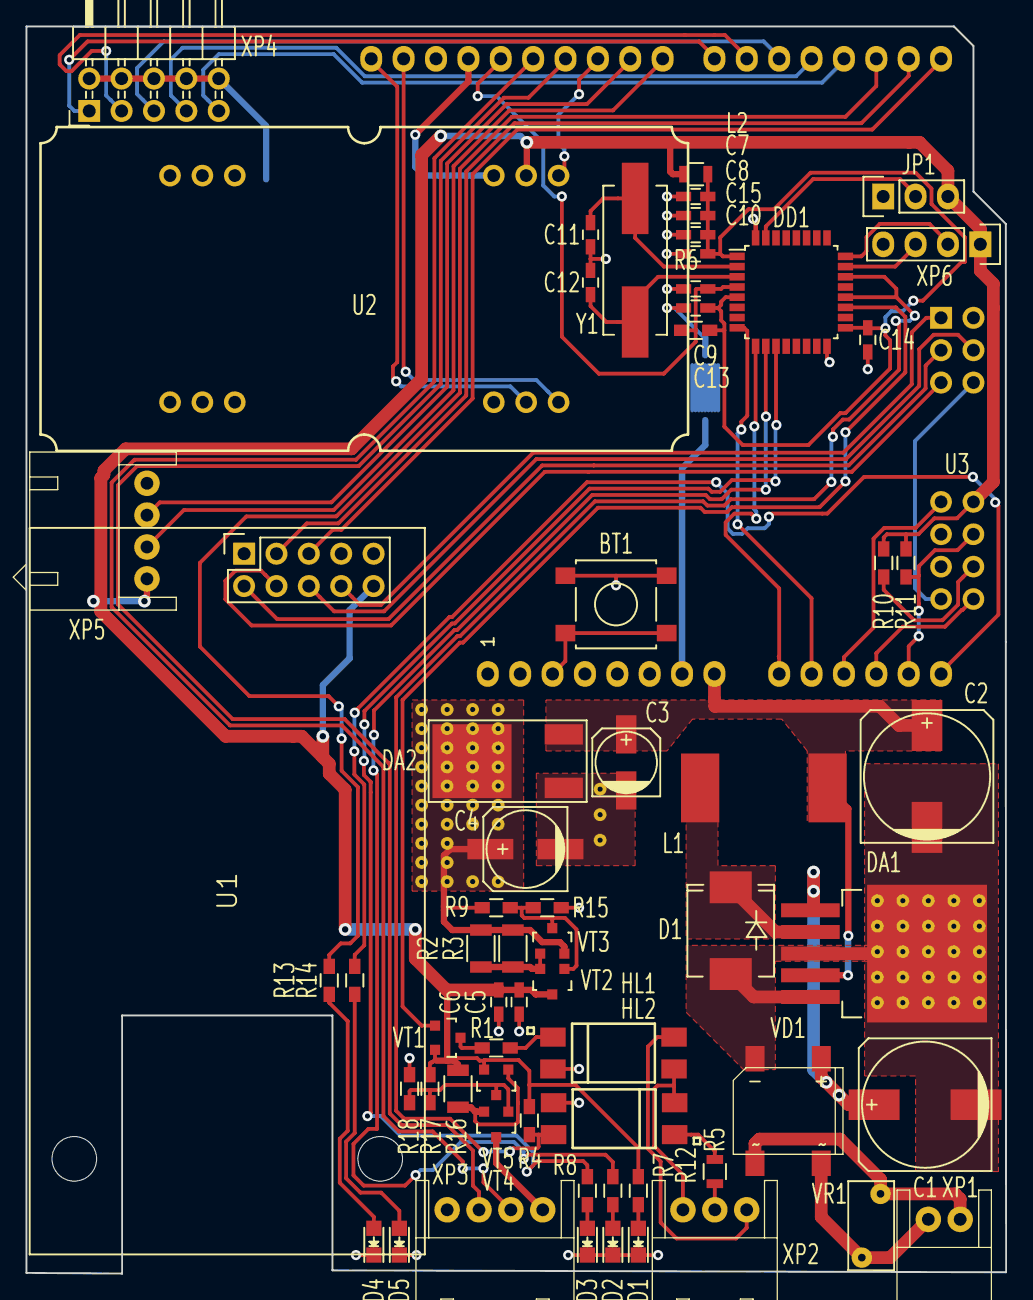
[picture p26: board KiCad.kicad_pcb from above]

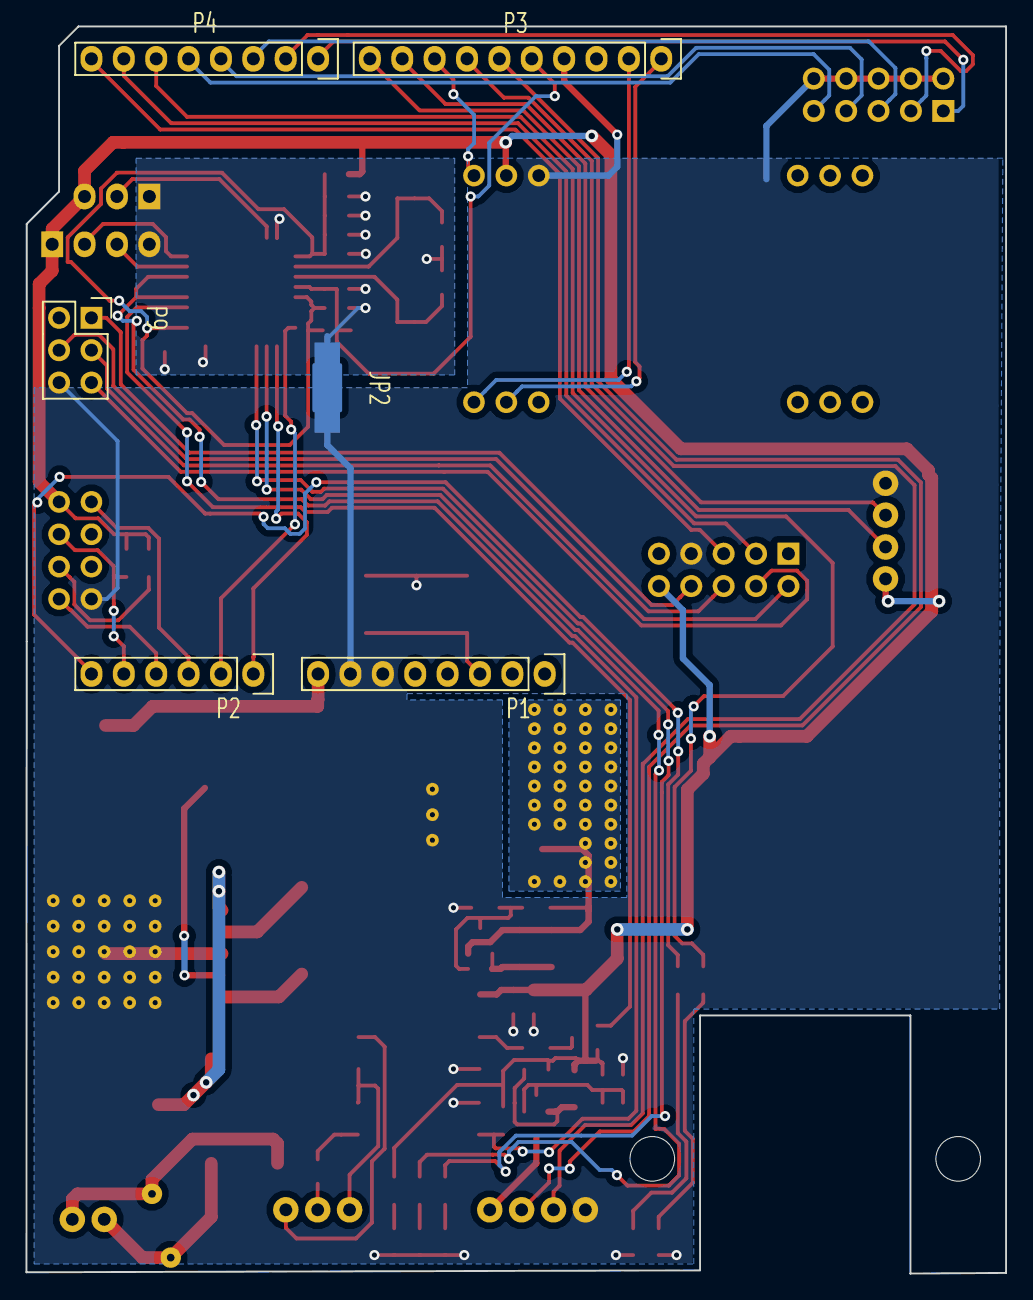
[picture p27: board KiCad.kicad_pcb from below]

Board: 2 copper layers, 76.9 x 97.8 mm, 71 parts (6 on the bottom side), 63 nets.
