vchernokulsky/cashless-dev/hardware/KiCad/W5500Shield/W5500 Shield - копия.kicad_pcb

## KiCad design hardware/KiCad/W5500Shield/W5500 Shield - копия.kicad_pcb (2016-11-25)

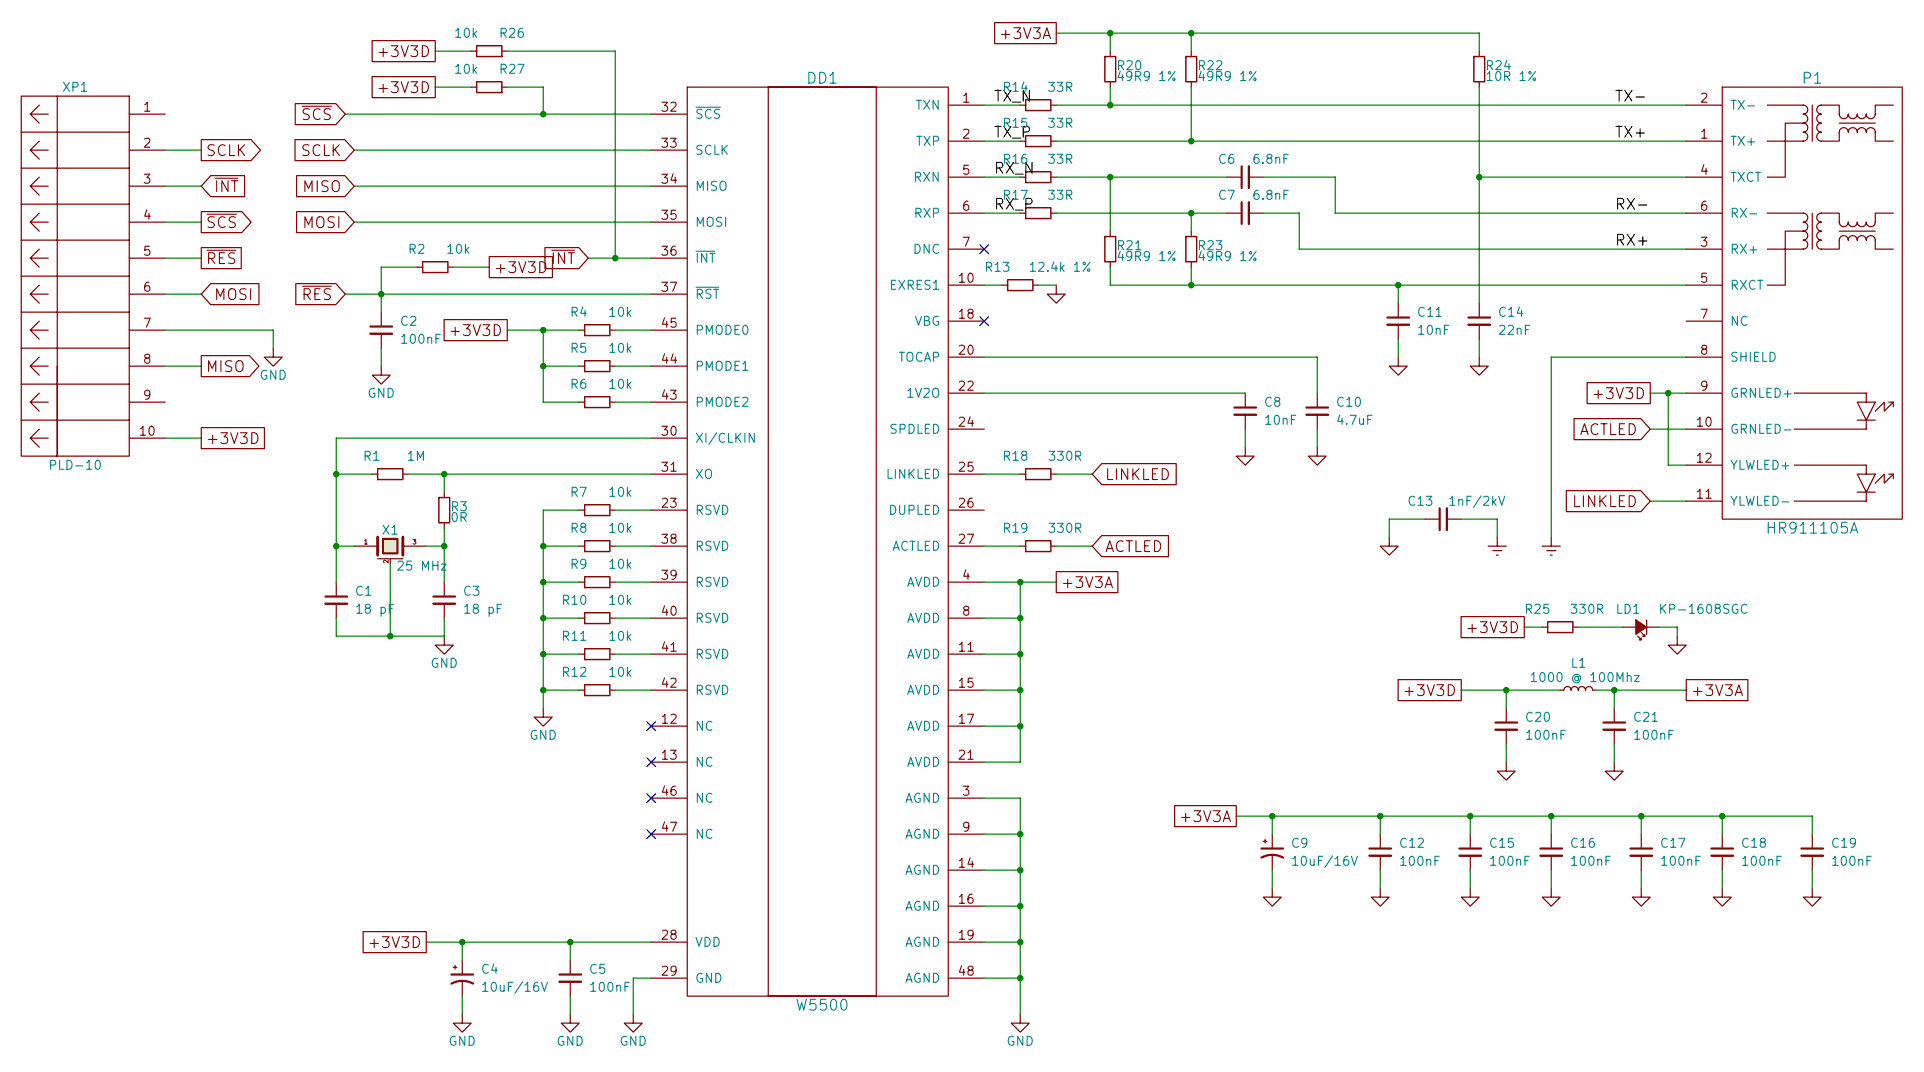
[picture p28: schematic W5500 Shield.sch]

Parts:
C1, C3: 18 pF; C_0603_HandSoldering
C2, C5, C12, C15, C16, C17, C18, C19, C20, C21: 100nF; C_0603_HandSoldering
C4, C9: 10uF/16V; TantalC_SizeA_EIA-3216_HandSoldering
C6, C7: 6.8nF; C_0603_HandSoldering
C8, C11: 10nF; C_0603_HandSoldering
C10: 4.7uF; C_0603_HandSoldering
C13: 1nF/2kV; C_1206
C14: 22nF; C_0603_HandSoldering
DD1: W5500; LQFP-48_7x7mm_Pitch0.5mm
L1: 1000 @ 100Mhz; R_0603_HandSoldering
LD1: KP-1608SGC; LED_0603
P1: HR911105A; HR911105
R1: 1M; R_0603_HandSoldering
R2, R4, R5, R6, R7, R8, R9, R10, R11, R12, R26, R27: 10k; R_0603_HandSoldering
R3: 0R; R_0603_HandSoldering
R13: 12.4k 1%; R_0603_HandSoldering
R14, R15, R16, R17: 33R; R_0603_HandSoldering
R18, R19, R25: 330R; R_0603_HandSoldering
R20, R21, R22, R23: 49R9 1%; R_0603_HandSoldering
R24: 10R 1%; R_0603_HandSoldering
X1: 25 MHz; ABM3C
XP1: PLD-10; Pin_Header_Straight_2x05

Connections:
+3V3A: C9.1, C12.1, C15.1, C16.1, C17.1, C18.1, C19.1, C21.1, DD1.4 (AVDD), DD1.8 (AVDD), DD1.11 (AVDD), DD1.15 (AVDD), DD1.17 (AVDD), DD1.21 (AVDD), L1.2, R20.1, R22.1, R24.1
+3V3D: C4.1, C5.1, C20.1, DD1.28 (VDD), L1.1, P1.9 (GRNLED+), P1.12 (YLWLED+), R2.2, R4.1, R5.1, R6.1, R25.1, R26.2, R27.2, XP1.10
/RX+: C7.2, P1.3 (RX+)
/RX-: C6.2, P1.6 (RX-)
/RX_N: DD1.5 (RXN), R16.1
/RX_P: DD1.6 (RXP), R17.1
/TX+: P1.1 (TX+), R15.2, R22.2
/TX-: P1.2 (TX-), R14.2, R20.2
/TX_N: DD1.1 (TXN), R14.1
/TX_P: DD1.2 (TXP), R15.1
ACTLED: P1.10 (GRNLED-), R19.2
Earth: C13.2, P1.0, P1.8 (SHIELD)
GND: C1.2, C2.2, C3.2, C4.2, C5.2, C8.2, C9.2, C10.2, C11.2, C12.2, C13.1, C14.2, C15.2, C16.2, C17.2, C18.2, C19.2, C20.2, C21.2, DD1.3 (AGND), DD1.9 (AGND), DD1.14 (AGND), DD1.16 (AGND), DD1.19 (AGND), DD1.29 (GND), DD1.48 (AGND), LD1.1 (K), R7.1, R8.1, R9.1, R10.1, R11.1, R12.1, R13.2, X1.2, XP1.7
LINKLED: P1.11 (YLWLED-), R18.2
MISO: DD1.34 (MISO), XP1.8
MOSI: DD1.35 (MOSI), XP1.6
unnamed: C1.1, DD1.30 (XI/CLKIN), R1.1, X1.1
unnamed: C3.1, R3.2, X1.3
unnamed: C6.1, R16.2, R21.1
unnamed: C7.1, R17.2, R23.1
unnamed: C8.1, DD1.22 (1V2O)
unnamed: C10.1, DD1.20 (TOCAP)
unnamed: C11.1, P1.5 (RXCT), R21.2, R23.2
unnamed: C14.1, P1.4 (TXCT), R24.2
unnamed: DD1.10 (EXRES1), R13.1
unnamed: DD1.23 (RSVD), R7.2
unnamed: DD1.25 (LINKLED), R18.1
unnamed: DD1.27 (ACTLED), R19.1
unnamed: DD1.31 (XO), R1.2, R3.1
unnamed: DD1.38 (RSVD), R8.2
unnamed: DD1.39 (RSVD), R9.2
unnamed: DD1.40 (RSVD), R10.2
unnamed: DD1.41 (RSVD), R11.2
unnamed: DD1.42 (RSVD), R12.2
unnamed: DD1.43 (PMODE2), R6.2
unnamed: DD1.44 (PMODE1), R5.2
unnamed: DD1.45 (PMODE0), R4.2
unnamed: LD1.2 (A), R25.2
SCLK: DD1.33 (SCLK), XP1.2
~INT: DD1.36 (~INT), R26.1, XP1.3
~RES: C2.1, DD1.37 (~RST), R2.1, XP1.5
~SCS: DD1.32 (~SCS), R27.1, XP1.4

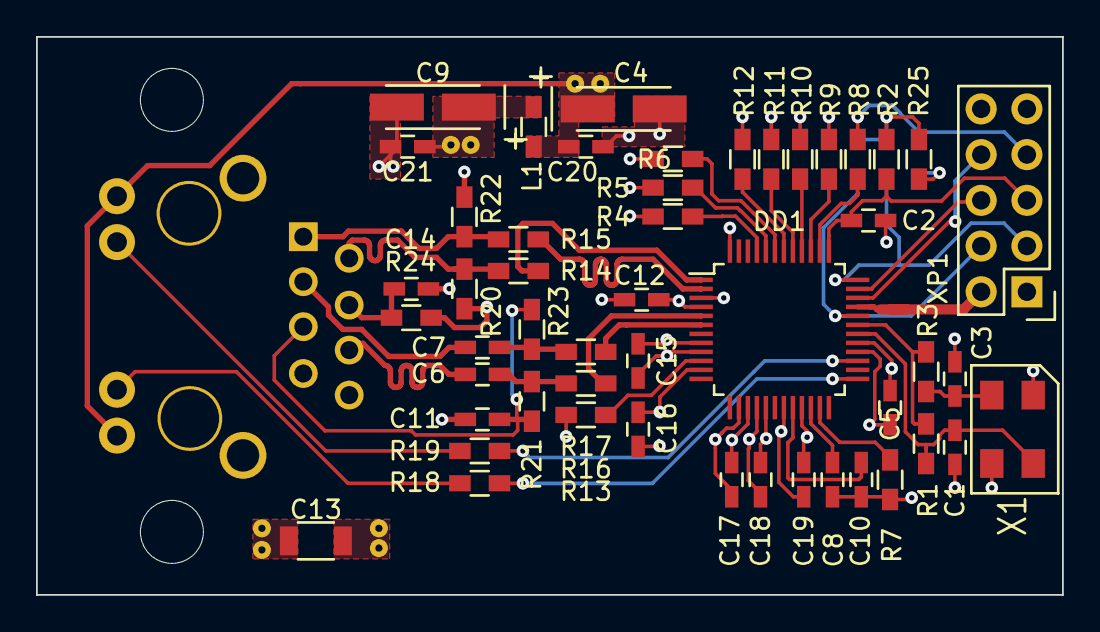
[picture p29: board W5500 Shield - копия.kicad_pcb from above]

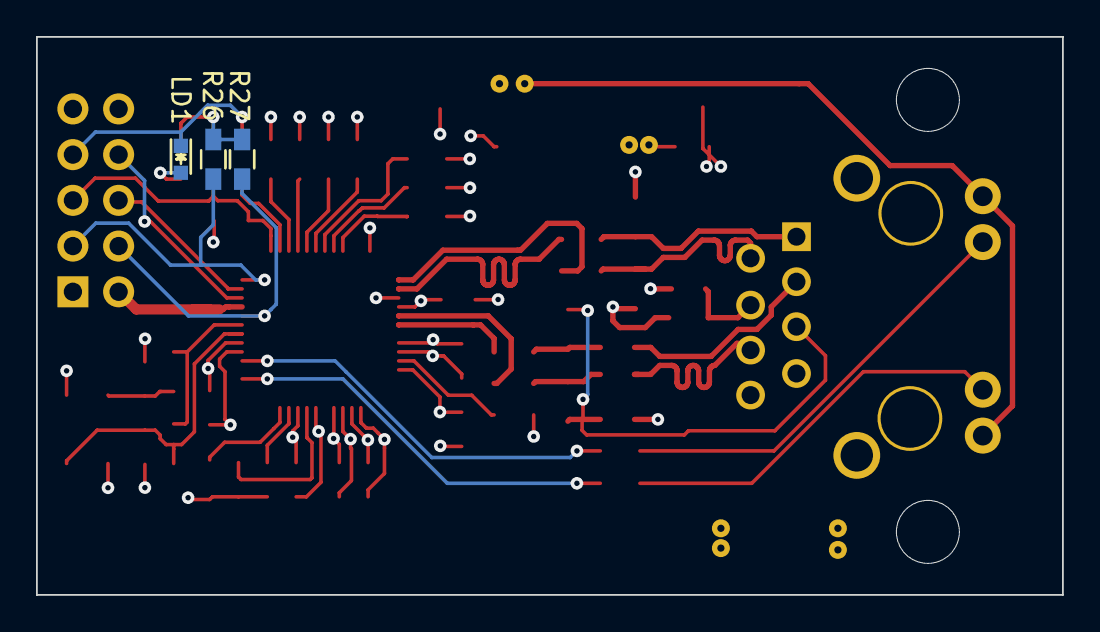
[picture p30: board W5500 Shield - копия.kicad_pcb from below]

Board: 4 copper layers, 57.0 x 31.0 mm, 54 parts (3 on the bottom side), 42 nets.
