vchernokulsky/cashless-dev/firmware/mic/MDBAdapterSTM32F042/MDBAdapterSTMF042/cashless_protocol.c

#include "platform.h"

#include <stdio.h>
#include <string.h>

#include "MDBConst.h"
#include "mdb_helper.h"
#include "internal_usart_comm.h"
#include "cashless_protocol.h"
#include "logger.h"

#if defined(__PLATFORM_STM32__)
#include "board.h"
#endif

// declare specific constants
unsigned short MAX_AMOUNT_VALUE = 65000;

// internal flags
unsigned short isBalanceReady = 0x00; // false
unsigned short isSessionCanceled = 0x00; // false
unsigned short isRefundCompleted = 0x00; // false
unsigned short isSessionComplete = 0x00; // false

// VENDING result variable
unsigned short vend_result_variable = VEND_NOTHING;
unsigned short vend_attempts_count = 0;
unsigned short session_timeout_seconds = 10;

// for success single vend scenario
char str_item_price[16];
char str_espr_cmd[23];
unsigned int item_price = 0;
unsigned int item_id     = 0;
unsigned int cur_balance = 0;
//temporary
unsigned char isInfoShown = 0x00;
// cashless FSM states
unsigned int _cashless_state = ST_INACTIVE;
unsigned int _delay_state;
// variables for store MDB response
struct Response delay_cmd;
struct Response last_cmd;
struct Response resp;

void getBalanceArray(unsigned short tmpBalance, char* result) {
	char chk;
	result[0] = 0x03;
	result[1] = (char) (tmpBalance >> 8);
	result[2] = (char) (tmpBalance & 0x00FF);
	chk = calculate_checksum(result, 4);
	result[3] = chk;
}

void process_inactive(unsigned char* data) {
	//define static responses
	char resp_ack[1] = { 0x00 };
	char resp_just_reset[2] = { 0x00, 0x00 };
	char resp_config_data[9] = {0x01, 0x02, 0x19, 0x78, 0x01, 0x02, 0x07, 0x03, 0xA1};
	/**/
	char resp_request_id[31] = { 0x09, 0x43, 0x4F, 0x4D, 0x30, 0x30, 0x30, 0x30,
			0x30, 0x30, 0x31, 0x34, 0x35, 0x33, 0x38, 0x36, 0x4E, 0x45, 0x57,
			0x5F, 0x45, 0x55, 0x52, 0x4F, 0x4B, 0x45, 0x59, 0x20, 0x02, 0x01,
			0xD3 };
	/**/
	/*
	char resp_request_id[44] = {0x09, 0x43, 0x4F, 0x4D, 0x30, 0x30, 0x30, 0x30,
			0x30, 0x30, 0x31, 0x34, 0x37, 0x31, 0x39, 0x39, 0x4E, 0x45, 0x57,
			0x5F, 0x45, 0x55, 0x52, 0x4F, 0x4B, 0x45, 0x59, 0x20, 0x02, 0x01,
			0x45, 0x57, 0x5F, 0x45, 0x55, 0x52, 0x4F, 0x4B, 0x45, 0x59, 0x20,
			0x02, 0x01, 0xD7 };
	*/
	int cmdId = (int) (data[0] & MASK_CMD);
	int subCmdId = -1;
	set_led_state(0x00);
	switch (cmdId) {
	case RESET:
		fill_mdb_command(&resp, resp_ack, 1);
		send_mdb_command(&resp);
		fill_mdb_command(&delay_cmd, resp_just_reset, 2);
		log("(INACTIVE)|RECV:RESET; SEND: ACK; DELAY: JUST RESET\n");
		break;
	case POLL:
		if (delay_cmd.length > 0) {
			send_mdb_command(&delay_cmd);
			log("(INACTIVE)|RECV:POLL ; SEND: delay_cmd\n");
			clear_mdb_command(&delay_cmd);
			if (_delay_state > 0) {
				_cashless_state = _delay_state;
				_delay_state = 0;
			}
		} else {
			fill_mdb_command(&resp, resp_ack, 1);
			send_mdb_command(&resp);
			log("(INACTIVE)|RECV:POLL ; SEND: ACK\n");
		}

		break;
	case SETUP:
		// RESPONSE: Reader Response
		subCmdId = (int) data[1];
		switch (subCmdId) {
		case 0x00: // VMC Config Data
			fill_mdb_command(&delay_cmd, resp_config_data, 9);
			fill_mdb_command(&resp, resp_ack, 1);
			send_mdb_command(&resp);
			log("(INACTIVE)|RECV:SETUP [config data] ; SEND: ACK; DELAY: CONFIG DATA\n");
			break;
		case 0x01: // Max / Min Price
			fill_mdb_command(&resp, resp_ack, 1);
			send_mdb_command(&resp);
			log("(INACTIVE)|RECV:SETUP [max min price] ; SEND: ACK\n");
			break;
		}
		break;
	case EXPANSION:
		subCmdId = (int) data[1];
		switch (subCmdId) {
		case 0x00: // request id
			fill_mdb_command(&resp, resp_ack, 1);
			send_mdb_command(&resp);
			fill_mdb_command(&delay_cmd, resp_request_id, 31);
			_delay_state = ST_DISABLED;
			log("(INACTIVE)|RECV:EXPANSION [request id]; SEND: ACK; DELAY: DEV ID\n");
			break;
		}
		break;
	default:
		subCmdId = data[1];
		log_mdb_command(ST_INACTIVE,cmdId,subCmdId);
		//log("(INACTIVE)|UNKNOWN COMMAND\n");
	}
}

void process_disabled(unsigned char* data) {
	char resp_ack[1] = { 0x00 };
	char resp_just_reset[2] = { 0x00, 0x00 };
	char resp_cmd_out_of_sequence[2] = { 0x0B, 0x0B };
	char pesn_expansion_id_request[4] = { 0x01, 0x02, 0xFF, 0x02 };

	int cmdId = (int) (data[0] & MASK_CMD);
	int subCmdId = -1;
	switch (cmdId) {
	case RESET:
		// process RESET command
		fill_mdb_command(&resp, resp_ack, 1);
		send_mdb_command(&resp);
		_cashless_state = ST_INACTIVE;
		// make delay_cmd: resp_just_reset
		fill_mdb_command(&delay_cmd, resp_just_reset, 2);
		log("(DISABLED)|RECV:RESET; SEND: ACK; DELAY: JUST RESET\n");
		break;
	case POLL:
		// process RESET command
		if (delay_cmd.length > 0) {
			send_mdb_command(&delay_cmd);
			clear_mdb_command(&delay_cmd);
			log("(DISABLED)|RECV:POLL; SEND: delay_cmd\n");
		} else {
			fill_mdb_command(&resp, resp_ack, 1);
			send_mdb_command(&resp);
			log("(DISABLED)|RECV:POLL; SEND: ACK\n");
		}
		break;
	case READER:
		subCmdId = (int) data[1];
		switch (subCmdId) {
		case 0x01: // Reader Enable
			fill_mdb_command(&resp, resp_ack, 1);
			send_mdb_command(&resp);
			_cashless_state = ST_ENABLED;
			// SEND to Espruino
			send_enable();
			//log("(DISABLED)|RECV:READER [reader enable]; SEND: Reader Enable\n");
			break;
		case 0x00: // Reader Disable
			fill_mdb_command(&resp, resp_ack, 1);
			send_mdb_command(&resp);
			log("(DISABLED)|RECV:READER [reader disable]; SEND: ACK\n");
			break;
		case 0x02: // Reader Cancel
			fill_mdb_command(&delay_cmd, resp_cmd_out_of_sequence, 2);
			break;
		}
		break;
	case EXPANSION:
		if (subCmdId == 0x00) { // EXPANSION ID REQUEST
			fill_mdb_command(&resp, resp_ack, 1);
			send_mdb_command(&resp);
			log("(DISABLED)|RECV:EXPANSION [id request]; SEND: ACK\n");
			fill_mdb_command(&delay_cmd, pesn_expansion_id_request, 4);
		}
		break;
	default:
		subCmdId = data[1];
		log_mdb_command(ST_DISABLED,cmdId,subCmdId);
		//log("(DISABLED)|UNKNOWN COMMAND\n");
	}
}

void process_enabled(unsigned char* data) {
	char resp_ack[1] = { 0x00 };
	char resp_just_reset[2] = { 0x00, 0x00 };
	char resp_display[34] = { 0x02, 0x64, 0x54, 0x4f, 0x55, 0x43, 0x48, 0x20,
			0x43, 0x41, 0x52, 0x44, 0x20, 0x20, 0x20, 0x20, 0x20, 0x20, 0x20,
			0x20, 0x20, 0x20, 0x20, 0x20, 0x20, 0x20, 0x20, 0x20, 0x20, 0x20,
			0x20, 0x20, 0x20, 0xc1 };
	char result[4] = { 0, 0, 0, 0 };
	char resp_end_session[2] = {0x07,0x07};
	unsigned short revalue_amount = 0;
	char resp_revalue_approved[2] = {0x0d, 0x0d};
	int cmdId = (int) (data[0] & MASK_CMD);
	int subCmdId = 0xFF;
	switch (cmdId) {
	case RESET:
		fill_mdb_command(&resp, resp_ack, 1);
		send_mdb_command(&resp);
		fill_mdb_command(&delay_cmd, resp_just_reset, 2);
		// change state to INACTIVE
		_cashless_state = ST_INACTIVE;
		log("(ENABLED)|RECV:RESET ; SEND: ACK\n");
		break;
	case POLL:
		cur_balance = read_user_balance();
		//log_recv_amount(cur_balance);
		if (cur_balance > 0) {  // BEGIN SESSION
			set_led_state(0x01);
			//cur_balance = cur_balance > MAX_AMOUNT_VALUE ? MAX_AMOUNT_VALUE : cur_balance;
			getBalanceArray(cur_balance, result);
			fill_mdb_command(&resp, result, 4);
			send_mdb_command(&resp);
			// safe to last_cmd
			vend_result_variable = VEND_NOTHING;
			fill_mdb_command(&last_cmd, result, 4);
			_cashless_state = ST_IDLE;
			//cur_balance = 0;
			log("(ENABLED)|RECV:POLL ; SEND: BEGIN SESSION\n");
		} else {
			// balance is not ready
			// Send ACK to VMC
			if(delay_cmd.length > 0) {
				send_mdb_command(&delay_cmd);
				clear_mdb_command(&delay_cmd);
				log("(ENABLED)|RECV:POLL ; SEND: [DELAY CMD]\n");
			} else {
				fill_mdb_command(&resp, resp_ack, 1);
				send_mdb_command(&resp);
				log("(ENABLED)|RECV:POLL ; SEND: ACK\n");
			}
		}
		break;
	case READER:
		subCmdId = data[1];
		switch (subCmdId) {
		case 0x00: //reader disable
			fill_mdb_command(&delay_cmd, resp_display, 34);
			fill_mdb_command(&resp, resp_ack, 1);
			send_mdb_command(&resp);
			log("(ENABLED)|RECV:READER[READER DISABLE]; SEND: ACK\n");
			break;
		case 0x01: // reader enable
			fill_mdb_command(&resp, resp_ack, 1);
			send_mdb_command(&resp);
			log("(ENABLED)|RECV:READER[READER ENABLE]; SEND: ACK\n");
			break;
		case 0x02: // reader cancel
			// TODO: send 0x08 - canceled
			log("(ENABLED)|RECV:READER[READER CANCEL]; SEND: ACK\n");
			break;
		}
		break;
	case VEND:
		subCmdId = data[1];
		switch(subCmdId){
			case 0x04: // Session Complete
				fill_mdb_command(&resp, resp_ack, 1);
				send_mdb_command(&resp);
				fill_mdb_command(&delay_cmd, resp_end_session, 2);
				log("(ENABLED)|RECV:VEND[SESSION COMPLETE] SEND:ACK\n");
			break;
			case 0x03: // vend failure
				fill_mdb_command(&resp, resp_ack, 1);
				send_mdb_command(&resp);
				fill_mdb_command(&delay_cmd, resp_end_session, 2);
				log("(ENABLED)|RECV:VEND[VEND FAILURE] SEND:ACK\n");
			break;
		}
	break;
	case REVALUE:
		subCmdId = data[1];
		switch(subCmdId) {
			case 0x00:   //REVALUE REQUEST
				fill_mdb_command(&resp, resp_ack, 1);
				fill_mdb_command(&delay_cmd, resp_revalue_approved, 2);
				send_mdb_command(&resp);
				revalue_amount = ((revalue_amount | (unsigned int)data[2]) << 8) | (unsigned int)data[3];
				send_revalue_info(revalue_amount);
				log("(ENABLED)|RECV:REVALUE[REVALUE REQUEST] SEND:ACK\n");
			break;
			case 0x01:   //REVALUE LIMIT REQUEST
				log("(ENABLED)|RECV:REVALUE[LIMIT RQUEST]\n");
			break;
		}
	break;
	default:
		subCmdId = data[1];
		log_mdb_command(ST_ENABLED,cmdId,subCmdId);
		//log("(ENABLED)|UNKNOWN COMMAND\n");
	}
}

void process_session_idle(unsigned char* data) {
	char resp_ack[1] = { 0x00 };
	char resp_just_reset[2] = { 0x00, 0x00 };
	char resp_revalue_limit[4] = { 0x0f, 0x00, 0x00, 0x00 };
	char resp_revalue_denied[2] = { 0x0e, 0x0e };
	char resp_session_cancel[2] = { 0x04, 0x04 };
	char resp_end_session[2] = { 0x07, 0x07 };
	char resp_vend_approved[4] = { 0, 0, 0, 0 };
	char resp_vend_denided[2] = {0x06, 0x06};
	char chk = 0x00;

	unsigned short revalue_limit;

	unsigned int value = 0;
	unsigned int value1 = 0;
	int cmdId = (int) (data[0] & MASK_CMD);
	int subCmdId = -1;
	switch (cmdId) {
	case RESET:
		fill_mdb_command(&resp, resp_ack, 1);
		send_mdb_command(&resp);
		fill_mdb_command(&delay_cmd, resp_just_reset, 2);
		// change state to INACTIVE
		_cashless_state = ST_INACTIVE;
		log("(IDLE)|RECV:RESET ; SEND: ACK\n");
		break;
	case VEND:
		subCmdId = (int) data[1];
		switch (subCmdId) {
		case 0x00: // Vend Request
			fill_mdb_command(&resp, resp_ack, 1);
			send_mdb_command(&resp);
			item_price = ((value | (unsigned int)data[2]) << 8) | (unsigned int) data[3];  //item price SCALED!!!
			item_id   = ((value1 | (unsigned int)data[4]) << 8) | (unsigned int)data[5];  //item number
			if(cur_balance >= item_price) {
				resp_vend_approved[0] = 0x05;
				resp_vend_approved[1] = (char) (item_price >> 8);
				resp_vend_approved[2] = (char) (item_price & 0x00FF);
				chk = calculate_checksum(resp_vend_approved, 4);
				resp_vend_approved[3] = chk;
				// delaycmd =  Vend Approved
				fill_mdb_command(&delay_cmd, resp_vend_approved, 4);
				_cashless_state = ST_VEND;
			}
			else {
				// not enought money
				fill_mdb_command(&delay_cmd, resp_vend_denided, 2);
				_cashless_state = ST_VEND;
			}
			log("(IDLE)|RECV:VEND[Vend Request] ; SEND: ACK\n");
			break;
		case 0x01: // Cancel Vend
			fill_mdb_command(&resp, resp_ack, 1);
			send_mdb_command(&resp);
			log("(IDLE)|RECV:VEND[Vend Denied] ; SEND: ACK\n");
			break;
		case 0x04: // Session Complete
			fill_mdb_command(&resp, resp_ack, 1);
			send_mdb_command(&resp);
			log("(IDLE)|RECV:VEND(Session Complete) ; SEND: ACK\n");
			break;
		default:
			log_mdb_command(ST_IDLE,cmdId,subCmdId);
			//log("(IDLE)|UNKNOWN SUBCOMMAND\n");
		}
		break;
	case REVALUE:
		subCmdId = (int) data[1];
		switch (subCmdId) {
		case 0x01: // Revalue Limit Request
			fill_mdb_command(&resp, resp_ack, 1);
			send_mdb_command(&resp);
			revalue_limit = 65000 - cur_balance;
			resp_revalue_limit[1] = (char)(revalue_limit >> 8);
			resp_revalue_limit[2] = (char)(revalue_limit & 0x00FF);
			chk = calculate_checksum(resp_revalue_limit, 4);
			resp_revalue_limit[3] = chk;
			fill_mdb_command(&delay_cmd, resp_revalue_limit, 4);
			log("(IDLE)|RECV:REVALUE(Limit Request) ; SEND: ACK\n");
			break;
		}
		break;
	case POLL:
		switch (vend_result_variable) {
		case VEND_NOTHING:
			if (delay_cmd.length > 0) {
				send_mdb_command(&delay_cmd);
				log("(IDLE)|RECV:POLL; SEND: delay_cmd\n");
				clear_mdb_command(&delay_cmd);
			} else {
				// increment vend timeout counter
				vend_attempts_count++;
				if (vend_attempts_count > 35) {
					vend_result_variable = VEND_CANCEL; //User timeout
					vend_attempts_count = 0;
				}
				//waiting user selection
				fill_mdb_command(&resp, resp_ack, 1);
				send_mdb_command(&resp);
				log("(IDLE)|RECV:POLL; SEND: ACK\n");
			}
			break;
		case VEND_CANCEL:
			// send Session Cancel
			fill_mdb_command(&resp, resp_session_cancel, 2);
			send_mdb_command(&resp);
			//lastCmd = [0x04, 0x04];
			fill_mdb_command(&last_cmd, resp_session_cancel, 2);
			_cashless_state = ST_ENABLED;
			//log("(IDLE)|RECV:POLL; SEND: 0x04 (SESSION CANCEL)\n");
			//switch off session indicator
			set_led_state(0x00);
			send_session_cancel();
			// Session Cancel => set to zero balance
			vend_attempts_count = 0;
			isBalanceReady = 0x00; // false
			cur_balance = 0;
			item_price = 0;
			item_id = 0;
			break;
		case VEND_SUCCESS:
			// send End Session
			fill_mdb_command(&resp, resp_end_session, 2);
			send_mdb_command(&resp);
			// lastCmd = [0x07, 0x07];
			fill_mdb_command(&last_cmd, resp_end_session, 2);
			_cashless_state = ST_ENABLED;
			// send product information
			send_vend_info(item_id, item_price);
			//switch off session indicator
			set_led_state(0x00);
			// end Session => set to zero balance
			vend_attempts_count = 0;
			isBalanceReady = 0x00; // false
			cur_balance = 0;
			item_price = 0;
			item_id = 0;
			break;
		}
		break;
	default:
		subCmdId = data[1];
		log_mdb_command(ST_IDLE,cmdId,subCmdId);
		//log("(IDLE)|UNKNOWN COMMAND\n");
	}
}

void process_vend(unsigned char* data) {
	char resp_ack[1] = { 0x00 };
	char resp_just_reset[2] = { 0x00, 0x00 };
	char chk;
	int cmdId = (int) (data[0] & MASK_CMD);

	int subCmdId = -1;
	switch (cmdId) {
	case RESET:
		fill_mdb_command(&resp, resp_ack, 1);
		send_mdb_command(&resp);
		fill_mdb_command(&delay_cmd, resp_just_reset, 2);
		_cashless_state = ST_INACTIVE;
		log("(VEND)|RECV:RESET ; SEND: ACK\n");
		break;
	case POLL:
		// No CoinMechanismPushes No SessionFailure
		if (delay_cmd.length > 0) {
			send_mdb_command(&delay_cmd);
			log("(VEND)|RECV:POLL; SEND: delay_cmd\n");
			clear_mdb_command(&delay_cmd);
		} else {
			fill_mdb_command(&resp, resp_ack, 1);
			send_mdb_command(&resp);
			log("(VEND)|RECV:POLL; SEND: ACK\n");
		}
		break;
	case VEND:
		subCmdId = (int) data[1];
		switch (subCmdId) {
		case 0x01: // CANCEL VEND
			fill_mdb_command(&resp, resp_ack, 1);
			send_mdb_command(&resp);
			vend_result_variable = VEND_CANCEL;
			log("(VEND)|RECV:VEND[CANCEL]; SEND:ACK\n");
			break;
		case 0x02: // VEND SUCCESS
			fill_mdb_command(&resp, resp_ack, 1);
			send_mdb_command(&resp);
			_cashless_state = ST_IDLE;
			vend_result_variable = VEND_SUCCESS;
			log("(VEND)|RECV:VEND[SUCCESS]; SEND: ACK\n");
			break;
		case 0x03: // VEND FAILURE
			// flag: price is not returned
			fill_mdb_command(&resp, resp_ack, 1);
			send_mdb_command(&resp);
			vend_result_variable = VEND_CANCEL;
			log("(VEND)|RECV:VEND[FAILURE]; SEND: ACK\n");
			//
			isRefundCompleted = 0x00; // false
			// refunding ...
			cur_balance += item_price;
			isRefundCompleted = 0x01; // true
			break;
			// process in failure scenario
		case 0x04: // SESSION COMPLETE
			fill_mdb_command(&resp, resp_ack, 1);
			send_mdb_command(&resp);
			_cashless_state = ST_IDLE;
			//TODO: this response is not as MDB protocol
			//vend_result_variable = VEND_SUCCESS;
			log("(VEND)|RECV:VEND[SESSION COMPLETE]; SEND: ACK\n");
			break;
		default:
			log_mdb_command(ST_VEND,cmdId,subCmdId);
		}
		break;
	default:
		subCmdId = data[1];
		log_mdb_command(ST_VEND,cmdId,subCmdId);
		//log("(VEND)|UNKNOWN COMMAND\n");
	}
}

void process_message(unsigned char* data) {
	//int cmd = (int)(data[0] & MASK_CMD);
	switch (_cashless_state) {
	case ST_INACTIVE:
		process_inactive(data);
		break;
	case ST_DISABLED:
		process_disabled(data);
		break;
	case ST_ENABLED:
		process_enabled(data);
		break;
	case ST_IDLE:
		process_session_idle(data);
		break;
	case ST_VEND:
		process_vend(data);
		break;
	}
}
