vchernokulsky/cashless-dev/firmware/mic/MDBAdapterSTM32F042/MDBAdapterSTMF042/internal_usart_comm.h

#include "platform.h"

// read from espruino functions
unsigned short read_user_balance();

// send to espruino functions
void send_startup();
void send_enable();
void send_disable();
void send_session_cancel();
void send_balance_echo(unsigned int balance);
void send_vend_info(unsigned short id, unsigned short price);
void send_revalue_info(unsigned short amount);
