vchernokulsky/cashless-dev/firmware/mic/MDBAdapter/logger.h

void log(const char* msg);
void log_array(const char *msg, const char *arr, unsigned int arr_len);
void log_recv_amount(unsigned short amount);
void log_mdb_command(unsigned short stateId, unsigned short cmdId, unsigned short subCmdId);
