vchernokulsky/cashless-dev/firmware/mic/MDBAdapter/cashless_protocol.h

//declare specific constants
#define  VEND_NOTHING 0x00
#define  VEND_CANCEL  0x01
#define  VEND_SUCCESS 0x02
#define  VEND_FAILURE 0x03

// function prototypes
void process_message(unsigned char* data);
