vchernokulsky/cashless-dev/(commit log)

2016-07-16 VMC mockup for PowerUp and VendSuccess sequences
2016-07-18 log for STM32 platform
2016-08-06 timeout in 5s for waiting espruino board
2016-08-23 fix device initialization
2016-08-29 Fixes in GloLime main
    [glolime_main.js]
2016-08-29 Detection additional "Error" added (Command Exit Codes for Glo Lime response)
    [glolime_main.js]
2016-09-03 Some changes and fixes in "mains"
    [glolime_main.js]
2016-09-12 some fixes for glolime main
    [glolime_main.js]
2016-09-15 change led behavior
2016-09-15 changes in LED behavior
2016-09-15 fix bug with approve vend always
    [cashless_protocol.c]
2016-09-16 socket stress-test
2016-09-18 refactoring: checking current sessionId in HTTP communication
2016-09-20 fix network timeout behaviour
    [glolime_main.js]
2016-09-21 fix bug with cyclic buffer reading
    [board.c]
2016-09-22 cosmetic fixes for schools
    [glolime_main.js]
2016-09-23 LED indication behaviour
2016-09-25 balance correctness check was add
    [board.c, cashless_protocol.c, logger.c]
2016-09-26 fixes for internal communications
    [glolime_main.js]
2016-10-05 led blink carousel
2016-10-12 config info in JSON (UART communication test)
2016-10-12 Transfer config info by UART
2016-10-26 fixes in bluetooth configuration
    [glolime_main.js]
2016-10-27 UART file settings
2016-11-25 Add Hardaware Files for Cashless Device
    [ABM3C.dxf, CDRH127.dxf, ESP8266-01.dxf, Ethernet-Shiled.dxf, KiCad.FCStd, KiCad.kicad_pcb, KiCad.sch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]
2017-01-19 fixes in network config setup
    [glolime_main_no_config.js]
2017-01-20 add network config store FIX: problem with balance conversion
    [glolime_main_no_config.js]
2018-08-15 partly reorganized
    [ABM3C.dxf, CDRH127.dxf, ESP8266-01.dxf, Ethernet-Shiled.dxf, KiCad.FCStd, KiCad.kicad_pcb, KiCad.sch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]
